jaapschellekens/aurea5-chofu-ctrl/docs/t0vTNs8miWJAVHOMbJF7yNvL.png

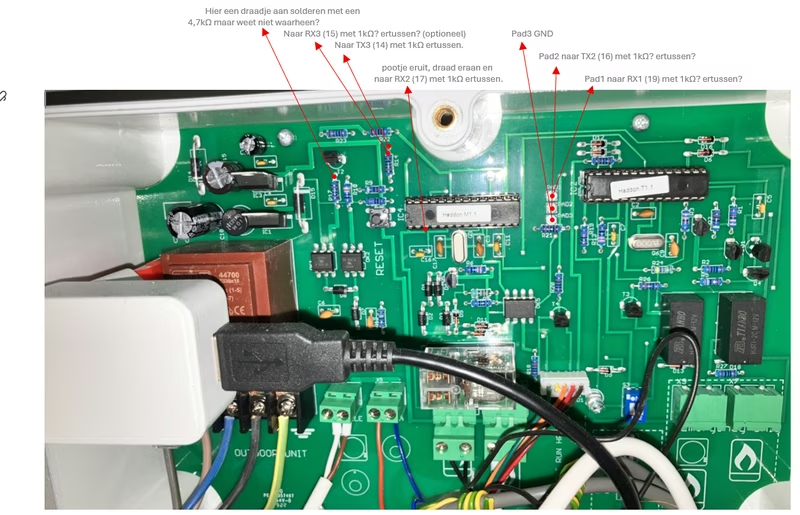
docs/t0vTNs8miWJAVHOMbJF7yNvL.png
