jaapschellekens/aurea5-chofu-ctrl/docs/pins.png

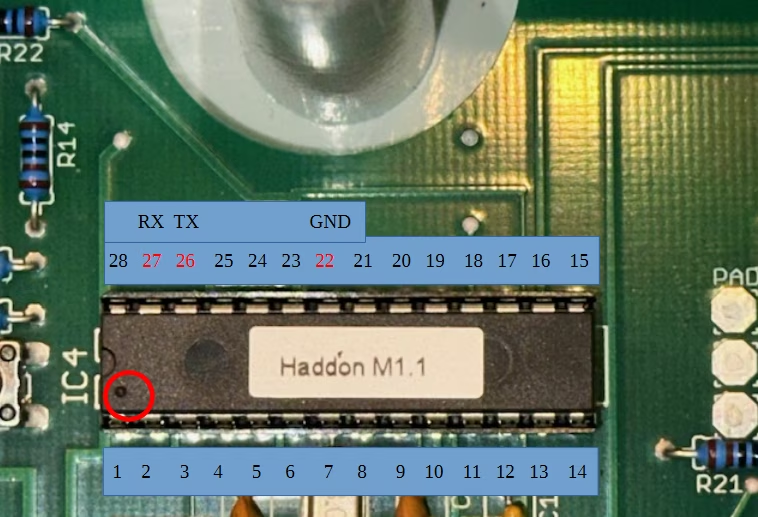
docs/pins.png
