jaapschellekens/aurea5-chofu-ctrl/README.md

# Chofu Warmtepomp Controller

**Arduino UNO R4 WiFi controller voor Chofu (Atlantic aurea 5) hybride warmtepomp met Home Assistant integratie**

> Fork van [kromhoutmaarten-sys/Aurea-5-hybrid_uno4](https://github.com/kromhoutmaarten-sys/Aurea-5-hybrid_uno4)

> Protocol en low level besturing gebaseerd op het werk van WackoH , \_JCG\_ en anderen in tweakers (https://gathering.tweakers.net/forum/list_messages/2220972/0) 





---

## Over Dit Project

Dit is een versie gebaseerd op de geforkte code, aaangevuld met een andere versie van het protocol dat door WackoH en \_JCG\_ is gepubliceerd op de genoemde tweakers thread.

Hoewel ik uiteindelijk veel handmatig heb gedaan is dit voor een groot deel met behulp van claude code en copilot gemaakt. 

De controller spreekt het Chofu 0x19/0x91 serieel protocol op **666 baud** (JGC multi-frame formaat, CRC-CCITT — zie [Protocol](#protocol)), regelt het compressorvermogen in standen 0–8 (handmatig tot 10), en integreert volledig met Home Assistant via MQTT auto-discovery.

- Dit is geen simpele oplossing, het is beperkt getest en kan de boel kapot maken
- Door de chip eruit te halen gaan de controlbox in storing (rode licht op de knop brand). Het gevolg is dat als je anna warmtevraag geeft de controlbox de gasketel aanzet. Mijn oplossing is de ketel in te stellen op tapwater alleen. Je kan de ketel ook op een aparte thermosthaat aansluiten
- De aansturing gaat via MQTT, het makkelijkste is om dat via Home assistant te doen

---

## Features

- **Vijf regelingsmodi** — Auto PID, Auto FF (feedforward), Water PID, Water FF, Handmatig
- **Feedforward controller** — model-gebaseerde stooklijn met online leren van UA_house en UA_emitter
- **Anna/Adam thermostaat support** — leest setpoint en kamertemperatuur via MQTT
- **Plugwise Adam API** (optioneel) — watersetpoint, koelvraag en zonetemperaturen rechtstreeks van de Adam, incl. multi-zone vraagsturing
- **Stooklijn compensatie** — aanvoertemperatuur omhoog bij vorst
- **Vorstbeveiliging** — automatisch bij instelbare grens
- **Koelmodus** — telegram 19-2 byte 3 = 0x02, regelaar draait automatisch om
- **MQTT Auto-Discovery** — entities verschijnen automatisch in Home Assistant
- **LCD display** — 16x2 I2C statusscherm (optioneel)
- **EEPROM opslag** — instellingen blijven na herstart

---

## Regelingsmodi

### Auto modus — PID

PID regelt de aanvoertemperatuur op basis van de kamertemperatuurafwijking (Anna setpoint). De stooklijn berekent het doel-setpoint; de PID past het compressorvermogen (stand) aan.

```
Kamer gewenst: 20.5°C (Anna setpoint)

20.7°C ════ UIT trigger (hysteresis boven)
20.5°C ──── Doel 
20.4°C ════ AAN trigger (hysteresis onder)
```

Geoptimaliseerde PID parameters (KGE-gecalibreerd op historische data):
```
Kp = 19.9   Ki = 0.084   Kd = 0.036
```

---

### Auto modus — FF (Feedforward)

Model-gebaseerde controller die de benodigde aanvoertemperatuur berekent uit de warmtebalans van het huis:

```
T_supply = T_kamer_gewenst + (UA_house / UA_emitter_eff) × (T_kamer_gewenst − T_buiten)
```

De UA_house waarde wordt online bijgeleerd via een integraalterm op de kamerfout. Dit maakt de FF controller robuust voor veranderingen in isolatiewaarden en zonnewinst.

Geoptimaliseerde FF parameters (gecalibreerd op een goed geisoleerd vrijstaand houten huis):
```
ff_UA_house   = 272.5 W/K  (startwaarde, wordt online bijgesteld)
ff_UA_emitter = 267.5 W/K  (UA_eff afgifte-circuit)
FF_KI_AUTO    = 0.026       (integraalversterking kamertemperatuur)
FF_COAST_AUTO = 0.54°C      (anticipatiezone — stand omhoog als fout > 0.54°C)
```

Selecteer modus via MQTT: `chofu/cmd/modus = "ff_auto"`

---

### Water modus — PID

Regelt op een vast aanvoertemperatuur setpoint, ongeacht de kamertemperatuur. Nuttig als sturing op basis van OpenTherm of extern signaal gewenst is. In mijn geval  om de Adam zoneregeling te kunnen gebruiken

```
Setpoint + 1°C ══ UIT trigger
Setpoint        ── Doel 
Setpoint - 1°C ══ AAN trigger
```

Vermogensafbouw is geleidelijk (1 stand per 5 minuten) voor compressorbescherming.

Selecteer: `chofu/cmd/modus = "water"`

---

### Water modus — FF (Feedforward)

Model-gebaseerde variant die de benodigde compressorstand berekent vanuit de gewenste aanvoertemperatuur en de geleerde UA_emitter. De UA_emitter waarde wordt online bijgeleerd via een integraalterm op de aanvoerfout. Rustiger gedrag dan de PID-variant (minder stand-wisselingen).

Geoptimaliseerde FF parameters (KGE-gecalibreerd):
```
ff_UA_emitter  = 267.5 W/K  (startwaarde, wordt online bijgesteld)
FF_KI_WATER    = 0.017       (integraalversterking aanvoertemperatuur)
FF_COAST_WATER = 4.76°C      (anticipatiezone — stand omhoog als fout > 4.76°C)
```

Selecteer: `chofu/cmd/modus = "ff_water"`

---

### Handmatige modus

Vaste compressorstand 0–10 via MQTT. PID/FF niet actief.
(Fabrieksbereik — de originele Atlantic-firmware moduleert t/m stand 10, zie chip-dump `data/atlantic`; de vroegere standen 11/12 waren extrapolaties en zijn geschrapt.)

```
Stand 0  =    0 W  (uit)
Stand 1  =  240 W
Stand 2  =  420 W
Stand 3  =  640 W
Stand 4  =  850 W
Stand 5  = 1050 W
Stand 6  = 1250 W
Stand 7  = 1450 W
Stand 8  = 1550 W  ← maximum in auto/water modus
─────────────────── alleen handmatig ───────────
Stand 9  = 1650 W
Stand 10 = 1700 W
```

---

### Koelmodus

Activeer via `chofu/cmd/koeling = "1"`. Koeling is **alleen beschikbaar** in `ff_auto`, `ff_water` en `handmatig` — niet in `auto` of `water`.

**FF_AUTO koeling** — feedforward op basis van warmte-inval van buiten:
```
P_nodig = UA_house × (t_outside − t_kamer_gewenst)
```
Regelt de compressorstand zodat de kamer op setpoint blijft.

**FF_WATER koeling** — feedforward op basis van kamer→water warmtestroom:
```
P_nodig = UA_emitter × (t_kamer − t_water_gewenst)
```
Regelt de aanvoertemperatuur op `t_water_gewenst` (bijv. 18°C).
Bij elke start vanuit stand 0 draait de pomp eerst 5 minuten op stand 1 voordat
hij naar een hogere berekende stand mag gaan. Dit voorkomt een te harde start
bij koelen.

**HANDMATIG** — vaste stand zoals bij verwarming.

**Condensatiebescherming:** aanvoer daalt nooit onder `SUPPLY_MIN` (default 17°C).  
**Afschakeldrempel:** koeling schakelt terug als kamer/aanvoer meer dan `KOELING_AFSCHAKEL` (0.5°C) onder setpoint zakt.  
**Seizoensbeveiliging:** koeling geblokkeerd als buiten < `KOELING_MIN_BUITEN` (default 18°C).

---

## Protocol

De firmware praat rechtstreeks met de warmtepomp via `Serial1` (D0/D1) op **666 baud, 8N1**. De Arduino vervangt de uitgelezen chip in de Aurea controlbox en is **master**: hij stuurt 4 roterende 0x19-polltelegrammen; de pomp antwoordt per poll met een 0x91-frame.

```
TX (Arduino → pomp):  [0x19][ID 0-3][lenbyte][data...][CRC hi][CRC lo]
RX (pomp → Arduino):  [0x91][ID 0-3][lenbyte][data...][CRC hi][CRC lo]
                      framelengte = lenbyte bytes, GEEN terminator
                      CRC-CCITT (init 0xFFFF, poly 0x1021), residu 0 over heel frame
```

Belangrijke bevindingen (juni 2026, zie [docs/ervaringen.md](docs/ervaringen.md)):

- De lijn is **half-duplex met echo**: eigen TX-bytes komen terug op RX.
- De "eindnul" uit de oorspronkelijke JGC-code is een **AVR-artefact** (break → 0x00); de Renesas-UART van de UNO R4 filtert die weg. Frames zijn exact `lenbyte` bytes.
- ID=2 bevat de temperaturen (aanvoer/retour/buiten, little-endian ×0,1 °C) en op pagina 0 (byte 9 = 0) ook persgas, verdamper, zuiggas en d4; ID=3 byte 3 = compressorfrequentie (×2/3 Hz), byte 9 = stroom (d3 = /5), byte 10 = compressorvermogen/25,6, byte 13 = circulatiepomp; ID=1 byte 4 = defrost, byte 9 = compressor-vrijgave, bytes 5–8 = vermoedelijk alarmvelden (bij wijziging → `chofu/alert`).
- Volledige byte-tabel met betrouwbaarheid per veld: [docs/extra-comm-info.txt](docs/extra-comm-info.txt).
- De JGC-parser (CRC-CCITT) is de enige ondersteunde parser; de pomp antwoordt niet op het oudere 25-byte formaat.

Voor busdiagnose zonder WiFi/MQTT: flash `sniffer/sniffer.ino` (pollt zelf en dumpt alle bytes als hex op USB-serial). Met `chofu/cmd/proto_log = 1` publiceert de firmware hex-frames op `chofu/proto/rx|tx` en elke 30 s een foutensamenvatting (`JGC (30s): CRC +x abort +y ok +z`).

---

## Hardware

### Vereist
- **Arduino UNO R4 WiFi** — hoofdcontroller (of ESP32 als alternatief)
- **LCD 16×2 I2C Display** (optioneel) — statusscherm

### Benodigde Arduino bibliotheken
- `ArduinoMqttClient`
- `LiquidCrystal_I2C` (optioneel, alleen als LCD aangesloten)
- `Arduino_LED_Matrix` (alleen UNO R4 WiFi)
- WiFi is ingebouwd: `WiFiS3` op UNO R4 WiFi, `WiFi` op ESP32

---

## Bedrading

### Warmtepomp seriële verbinding

```
Arduino D0 (RX1) ←── pad "RX" op IC-voetje (pomp → Arduino)
Arduino D1 (TX1) ──→ pad "TX" op IC-voetje (Arduino → pomp, via 1kΩ!)
Arduino GND      ───  GND controlbox
```

> **Let op:** de RX/TX-labels op het IC-voetje zijn vanuit de *verwijderde chip* gezien — de Arduino vervangt die chip en stuurt dus pad "TX" met zijn eigen TX aan. Verkeerd om aangesloten = polls gaan uit maar de pomp antwoordt nooit. Zie [docs/WIRING.md](docs/WIRING.md).

### OpenTherm-link (optioneel, experimenteel)
```
IC-voetje pin 2 ──[10kΩ]──→ D8   (alleen luisteren, fase 1)
```
Zie [docs/WIRING.md](docs/WIRING.md) en [docs/OPENTHERM_LINK_PLAN.md](docs/OPENTHERM_LINK_PLAN.md) — let op de waarschuwingen (T1.1 is onvervangbaar).

### LCD Display (optioneel)
```
VCC → 5V
GND → GND
SDA → A4
SCL → A5
```

---

## Installatie

### 1. Bibliotheken installeren
Arduino IDE → Sketch → Bibliotheek beheren:
- `ArduinoMqttClient` 
- `LiquidCrystal_I2C` 

### 2. Configuratie aanmaken
Kopieer het voorbeeldbestand en vul je eigen gegevens in:
```bash
cp chofu_wp_ff/config.h.example chofu_wp_ff/config.h
```
Bewerk `chofu_wp_ff/config.h`:
```cpp
const char* SSID        = "jouw-netwerk";
const char* PASS        = "jouw-wachtwoord";
const char* MQTT_BROKER = "192.168.1.x";
const int   MQTT_PORT   = 1883;
const char* MQTT_USER   = "";   // leeg als geen auth
const char* MQTT_PASS   = "";
```
`config.h` staat in `.gitignore` en wordt nooit gecommit.

### 3. Firmware uploaden
Open `chofu_wp_ff/chofu_wp_ff.ino` en upload naar Arduino UNO R4 WiFi.

> **⏱ Koude-start vertraging:** Na elke upload of stroomonderbreking blijft de WP **5 minuten** op stand 0 voordat de regelaar ingrijpt. Na 5 minuten verschijnt `"Koude-start vertraging afgelopen"` op `chofu/log/INFO`.

### 3. Home Assistant
Entities verschijnen automatisch via MQTT discovery zodra de Arduino verbonden is. Geen YAML configuratie nodig.

Zie [docs/INSTALLATION.md](docs/INSTALLATION.md) voor uitgebreide stap-voor-stap instructies.

---

## MQTT Topics

### State (Arduino → HA)

| Topic | Omschrijving | Eenheid |
|---|---|---|
| `chofu/supply` | Aanvoertemperatuur | °C |
| `chofu/return` | Retourtemperatuur | °C |
| `chofu/outside` | Buitentemperatuur | °C |
| `chofu/kamer` | Kamertemperatuur (Anna) | °C |
| `chofu/kamer_gewenst` | Gewenste kamertemperatuur | °C |
| `chofu/stand` | Compressorstand (0–10) | — |
| `chofu/vermogen` | Gemeten compressorvermogen | W |
| `chofu/stroom` | Stroom (display d3) | — |
| `chofu/comp_hz` | Compressorfrequentie | Hz |
| `chofu/t_persgas` | Persgastemperatuur | °C |
| `chofu/comp_vrijgave` | Compressor vrijgegeven door pomp | 0/1 |
| `chofu/circ_pomp` | Circulatiepomp draait | 0/1 |
| `chofu/diag` | Diagnose-JSON (verdamper, zuiggas, ventilator, EEV, statusbytes) | JSON |
| `chofu/delta_t` | Aanvoer − retour | °C |
| `chofu/modus` | Huidige modus | auto/ff_auto/water/ff_water/handmatig |
| `chofu/stooklijn_basis` | Actief aanvoer setpoint | °C |
| `chofu/doel_setpoint` | Actief regelsetpoint (stooklijn bij verwarming, kamer/water bij koeling) | °C |
| `chofu/water_setpoint` | Water modus setpoint | °C |
| `chofu/pid` | PID uitvoer | % |
| `chofu/ff_ua_house` | Geleerde UA_house (FF) | W/K |
| `chofu/ff_ua_emitter` | Geleerde UA_emitter (FF) | W/K |
| `chofu/koeling` | Koelmodus actief | 0/1 |
| `chofu/supply_min` | Condensatiegrens koeling | °C |
| `chofu/koeling_afschakel` | Afschakeldrempel koeling | °C |
| `chofu/defrost` | Ontdooien actief | 0/1 |
| `chofu/aan` | WP actief | 0/1 |
| `chofu/t_vorst` | Vorstbeveiligingsgrens | °C |
| `chofu/status` | Verbindingsstatus | online/offline |

### Commands (HA → Arduino)

| Topic | Omschrijving | Waarden |
|---|---|---|
| `chofu/cmd/modus` | Selecteer modus | `auto` / `ff_auto` / `water` / `ff_water` / `handmatig` |
| `chofu/cmd/stand` | Vaste stand (→ handmatig) | 0–10 |
| `chofu/cmd/water_setpoint` | Aanvoer setpoint water modus (koeling: ~16–20) | 16–55°C |
| `chofu/cmd/stooklijn_basis` | Aanvoer setpoint auto stooklijn | 20–45°C |
| `chofu/cmd/koeling` | Koelmodus aan/uit | 0/1 |
| `chofu/cmd/koeling_min_buiten` | Min. buitentemp voor koeling (EEPROM) | 0–30°C |
| `chofu/cmd/supply_min` | Condensatiebescherming koeling (EEPROM) | 10–25°C |
| `chofu/cmd/koeling_afschakel` | Afschakeldrempel koeling | 0.1–5.0°C |
| `chofu/cmd/adam_bron` | Plugwise Adam bron (EEPROM) | `uit`/`water`/`water+kamer`/`multi` |
| `chofu/cmd/adam_koel_sp` | Watersetpoint bij Adam-koelvraag (EEPROM) | 16–25°C |
| `chofu/cmd/proto_log` | Protocol hex-logging aan/uit | 0/1 |
| `chofu/cmd/power` | WP aan/uit | 0/1 |
| `chofu/cmd/t_vorst` | Vorstgrens | −10 tot 10°C |
| `chofu/cmd/kp` / `ki` / `kd` | PID parameters | getal |
| `chofu/cmd/ff_ua_house` | FF UA_house overschrijven | W/K |
| `chofu/cmd/ff_ua_emitter` | FF UA_emitter overschrijven | W/K |
| `chofu/cmd/ff_save` | FF leerwaarden opslaan in EEPROM | 1 |
| `chofu/cmd/stooklijn_grens` | Buitentemp grens stooklijn | °C |
| `chofu/cmd/stooklijn_factor` | Stooklijn steilheid | 0.1–5.0 |
| `chofu/cmd/supply_max` | Max aanvoertemperatuur | °C |
| `chofu/cmd/force_start` | Hysteresis overbruggen | 1 |
| `chofu/cmd/hyst_slow` / `fast` / `down` | Hysteresistijden | ms |

### Subscriptions (Arduino leest)

| Topic | Omschrijving |
|---|---|
| `chofu/cmd/kamer_setpoint` | Anna thermostaat setpoint |
| `chofu/cmd/kamer` | Anna kamertemperatuur |

### Log

| Topic | Omschrijving |
|---|---|
| `chofu/log/INFO` | Normale events |
| `chofu/log/WARNING` | Waarschuwingen |
| `chofu/alert` | Persistente waarschuwing (retained) |

---

## Plugwise Adam integratie (ingebouwd)

De firmware kan optioneel rechtstreeks de lokale REST API van de Plugwise Adam pollen (`adam.h`/`adam.cpp`, niet-blokkerend, elke 30 s). Volledig ontwerp: [docs/ADAM_INTEGRATIE_PLAN.md](docs/ADAM_INTEGRATIE_PLAN.md).

**Activeren:** zet in `config.h`:
```cpp
#define ADAM_IP   "192.168.1.x"
#define ADAM_PASS "abcd1234"     // Smile-ID van sticker
#define ADAM_ZONE "Woonkamer"    // zonenaam voor bron water+kamer
```
en kies een bron via `chofu/cmd/adam_bron` (EEPROM):

| Bron | Gedrag |
|---|---|
| `uit` | Adam wordt niet gebruikt (default); MQTT-bronnen zoals voorheen |
| `water` | `intended_boiler_temperature` → `t_water_gewenst` (water/ff_water) |
| `water+kamer` | Als `water`, plus temperatuur van `ADAM_ZONE` → `t_kamer` |
| `multi` | Als `water`, plus regelen op de zone met de **grootste vraag** (setpoint − temp, 0,3 °C wissel-hysterese); het zonesetpoint vervangt het Anna-setpoint |

**Watersetpoint-interpretatie** (Anna via Adam): `0` = geen vraag → WP uit; `10` = **koelvraag** → koeling aan op `chofu/cmd/adam_koel_sp` (default 18 °C, alleen ff_water); `≥ 16` = verwarmen op dat setpoint.

**Terugval:** is de API > 90 s onbereikbaar, dan gelden weer de laatste MQTT-waarden + alert. Alle beveiligingen (SUPPLY_MIN, KOELING_MIN_BUITEN, vorst) blijven leidend.

**State topics:** `chofu/adam/bron`, `chofu/adam/sp`, `chofu/adam/status`, `chofu/adam/koel_sp`, `chofu/adam/zone/<naam>` (+ `_sp`), `chofu/adam/actieve_zone` (multi).

De map `adam_api_test/` bevat de oorspronkelijke proof-of-concept plus `adam_discover.py` (Python) om zonenamen en beschikbare data te verkennen.

---

## Python simulatietools

De map `python/` bevat tools voor het optimaliseren en valideren van regelparameters op historische Home Assistant data.

| Script | Functie |
|---|---|
| `replay_simulation.py` | Simuleer controller op historische CSV data |
| `optimize_all.py` | Optimaliseer PID en FF parameters (KGE objectief) |
| `calibrate_housemodel.py` | Kalibreer UA_house, C_th, UA_emitter op historische kamertemperatuur |

**Data-indeling:** exporteer via Home Assistant → Geschiedenis → CSV. Ondersteunt zowel het oude (entity/state) als het nieuwere formaat met `climate`-entiteiten en OpenTherm-sensoren.

---

## Troubleshooting

### Entities verschijnen niet in Home Assistant
- Wacht 2–3 minuten na opstarten
- Check of MQTT integratie geïnstalleerd is
- Controleer `chofu/status` topic in MQTT Explorer — moet "online" tonen
- Herstart Home Assistant als entities na integratie-reload verdwijnen

### WP gaat niet aan
- Hysteresis actief? (standaard 10 min)
- Override via: `chofu/cmd/force_start = 1`
- Check of modus correct is: `chofu/modus`

### Arduino bevriest na enige tijd
- Gebruik uitsluitend de hardware UART (Serial1, pins D0/D1) voor de WP-communicatie. SoftwareSerial conflicteert met de WiFi co-processor van de UNO R4 WiFi.

### Geen of corrupte protocol-communicatie
- Zet `chofu/cmd/proto_log = 1` en kijk naar de 30s-samenvatting: `JGC (30s): CRC +x abort +y ok +z`. Gezond is `ok` in de tientallen en CRC/abort ~0.
- `JGC timeout: geen frame >2s` + geen antwoord → D0/D1 waarschijnlijk verwisseld (labels op IC-voetje zijn vanuit de verwijderde chip!)
- Voor diagnose op byte-niveau: flash `sniffer/sniffer.ino` (geen WiFi, hex-dump op USB-serial)

---

## Documentatie

- [docs/INSTALLATION.md](docs/INSTALLATION.md) — Installatie handleiding
- [docs/WIRING.md](docs/WIRING.md) — Bekabelingsschema's
- [docs/MQTT_REFERENCE.md](docs/MQTT_REFERENCE.md) — Volledige MQTT referentie
- [docs/TUNING.md](docs/TUNING.md) — PID en feedforward parameter tuning gids
- [docs/STOOKLIJN.md](docs/STOOKLIJN.md) — Stooklijn werking en instelling
- [docs/LCD.md](docs/LCD.md) — LCD scherm-indeling per modus
- [docs/ervaringen.md](docs/ervaringen.md) — Valkuilen en bevindingen uit de ontwikkeling
- [docs/ESPHOME_AVR_BRUG_PLAN.md](docs/ESPHOME_AVR_BRUG_PLAN.md) — Plan: ATmega328P-brug in IC2 en eventuele overstap naar ESPHome

---

## Credits

Protocol reverse engineering: WackoH (Tweakers.net) — [Tweakers topic](https://gathering.tweakers.net/forum/list_messages/2220972/0)
Fork van [kromhoutmaarten-sys/Aurea-5-hybrid_uno4](https://github.com/kromhoutmaarten-sys/Aurea-5-hybrid_uno4)

**Bibliotheken:**
- ArduinoMqttClient (Arduino)
- LiquidCrystal_I2C (Frank de Brabander)

---

## Licentie

MIT License — zie [LICENSE](LICENSE) voor details.
