jaapschellekens/aurea5-chofu-ctrl/docs/MQTT_REFERENCE.md

# MQTT Referentie - ChofuCtrl

Complete overzicht van alle MQTT topics, commando's en HA discovery entiteiten.

MQTT Broker: `<YOUR_MQTT_BROKER_IP>:1883`  
Alle topics gebruiken het prefix `chofu/` (instelbaar — zie hieronder).

---

## MQTT-prefix / HA-device (testbord naast productie)

De topic-prefix en de Home Assistant device-identiteit zijn **compile-time**
instelbaar via drie macro's in `chofu_wp_ff/types.h`:

| Macro | Default (productie) | Bepaalt |
|---|---|---|
| `MQTT_PREFIX` | `chofu` | Prefix van álle topics (`<prefix>/...`) |
| `HA_NODE` | `chofu_hp` | HA device-id, alle `unique_id`'s, discovery-node, **én de MQTT client-ID** |
| `HA_DEV_NAME` | `Chofu WP` | Weergavenaam van het HA-device |

In deze referentie staat overal `chofu/...`; lees dat als `<MQTT_PREFIX>/...`.

**Tweede (test)bord naast het draaiende systeem:** zet op het testbord bv.
`MQTT_PREFIX "chofu_test"`, `HA_NODE "chofu_test_hp"`, `HA_DEV_NAME "Chofu WP TEST"`.
Omdat `HA_NODE` ook de `unique_id`'s, het device-id én de MQTT client-ID verandert,
ziet HA een **apart apparaat** en botsen de broker-verbindingen niet (geen
reconnect-storm). De productietopics/-entiteiten blijven onaangeroerd.

> Niet in `config.h` zetten: dat bestand wordt niet door alle `.cpp`-bestanden
> gezien → zou inconsistente topics geven. Kan ook globaal via build-flag,
> bv. `-DMQTT_PREFIX="\"chofu_test\""`.

De simulator `python/wp_simulator.py` heeft een bijpassende `--prefix`-optie
(default `chofu`); zet die gelijk aan `MQTT_PREFIX`, bv. `--prefix chofu_test`.

---

## State Topics (Arduino → Home Assistant)

Alle state topics worden elke **10 seconden** gepubliceerd. HA discovery zorgt automatisch voor de entiteiten.

### Temperaturen

| Topic | Type | Unit | Beschrijving |
|---|---|---|---|
| `chofu/supply` | float | °C | Aanvoer temperatuur |
| `chofu/return` | float | °C | Retour temperatuur |
| `chofu/outside` | float | °C | Buiten temperatuur |
| `chofu/delta_t` | float | °C | Delta T (aanvoer − retour) |
| `chofu/kamer` | float | °C | Kamer temperatuur (van Anna) |
| `chofu/kamer_gewenst` | float | °C | Gewenste kamer temperatuur (van Anna) |
| `chofu/kamer_geldig` | string | 0/1 | Kamertemperatuur ooit ontvangen (0 = nog nooit via cmd/kamer) |
| `chofu/kamer_in_water` | string | 0/1 | Kamertemp actief in ff_water/water-modi |
| `chofu/stooklijn_basis` | float | °C | Aanvoer setpoint (auto modus stooklijn) |
| `chofu/water_setpoint` | float | °C | Gewenste aanvoertemperatuur (water modus); 0 = geen warmtevraag |
| `chofu/water_sp_min` | float | °C | Minimaal geldig water setpoint (exclusief 0) |
| `chofu/t_vorst` | float | °C | Actieve vorstgrens |

### Status

| Topic | Type | Values | Beschrijving |
|---|---|---|---|
| `chofu/stand` | int | 0–10 | Huidige compressor stand |
| `chofu/vermogen` | int | W | Compressorvermogen (gemeten: frame 91-3 byte 10 × 25.6; terugval: standtabel) |
| `chofu/aan` | string | 0/1 | Warmtepomp aan/uit |
| `chofu/modus` | string | auto/ff_auto/water/ff_water/handmatig | Regelingsmodus |
| `chofu/doel_setpoint` | float | °C | Actief doel-setpoint (stooklijn) |
| `chofu/koeling` | string | 0/1 | Koelstand actief |
| `chofu/pid` | float | % | PID/FF output |
| `chofu/ff_ua_house` | float | W/K | Geleerde UA huis (FF auto) |
| `chofu/ff_ua_emitter` | float | W/K | Geleerde UA emitter (FF water) |
| `chofu/defrost` | string | 0/1 | Defrost actief |
| `chofu/stroom` | float | — | Stroom zoals display d3 (frame 91-3 byte 9 / 5; eenheid niet bewezen). Vervangt het oude `chofu/stand_echo`, dat een verkeerde interpretatie was |
| `chofu/comp_hz` | int | Hz | Compressorfrequentie (91-3 byte 3 × 2/3, display d1) |
| `chofu/t_persgas` | int | °C | Persgastemperatuur (91-2 byte 13, display d2) |
| `chofu/comp_vrijgave` | string | 0/1 | Pomp geeft compressor vrij (91-1 byte 9 ≠ 0); 0 tijdens de ~3 min herstartblokkade en vlak vóór defrost |
| `chofu/circ_pomp` | string | 0/1 | Circulatiepomp draait (91-3 byte 13: 24 = uit, ~152 = aan); loopt ~1¾ min vóór de compressor aan en draait na |
| `chofu/diag` | JSON | — | Diagnose: `t_verdamper`, `t_zuiggas`, `t_d4` (°C, raw/2 − 41), `ventilator_rpm`, `ventilator_doel_rpm`, `eev` (pulsen), statusbytes (hex) en onbekende bytes |
| `chofu/lcd` | string | 0/1 | LCD backlight status |
| `chofu/sim_actief` | string | 0/1 | Simulatiemodus actief |
| `chofu/proto_log` | string | 0/1 | Protocol logging actief |

### Safeguard Grenzen (instelbaar)

| Topic | Type | Unit | Default | Beschrijving |
|---|---|---|---|---|
| `chofu/supply_max` | float | °C | 60.0 | Noodstop aanvoer temperatuur |
| `chofu/koeling_min_buiten` | float | °C | 18.0 | Minimale buitentemp voor koeling |
| `chofu/supply_min` | float | °C | 17.0 | Condensatiebescherming koeling |
| `chofu/koeling_afschakel` | float | °C | 0.5 | Afschakeldrempel koeling (niet EEPROM) |
| `chofu/stooklijn_uit` | float | °C | 18.0 | Boven deze buitentemp: verwarming uit (auto) |
| `chofu/stooklijn_aan` | float | °C | 16.0 | Onder deze buitentemp: verwarming hervat (hysteresis) |

### Systeem

| Topic | Type | Retained | Beschrijving |
|---|---|---|---|
| `chofu/status` | string | ✅ | `online` / `offline` (LWT) |
| `chofu/alert` | string | ✅ | Laatste waarschuwing of foutmelding |
| `chofu/log/INFO` | string | ❌ | Normale events |
| `chofu/log/WARNING` | string | ❌ | Waarschuwingen (ook via alert) |
| `chofu/log/ERROR` | string | ❌ | Fouten |

> `chofu/alert` is retained: HA toont altijd het laatste bericht, ook na herstart.

---

## Command Topics (Home Assistant → Arduino)

### Modus

```
Topic:   chofu/cmd/modus
Payload: "auto"      → PID regeling op kamertemperatuur (Anna)
         "ff_auto"   → Feedforward op kamertemperatuur (leert UA_house)
         "water"     → PID regeling op aanvoertemperatuur
         "ff_water"  → Feedforward op aanvoertemperatuur (leert UA_emitter)
                       Werkt ook zonder kamertemperatuur — zie kamer_in_water.
         "handmatig" → Vaste stand via chofu/cmd/stand
```

### Power

```
Topic:   chofu/cmd/power
Payload: "1" → AAN (schakelt naar handmatig stand 1)
         "0" → UIT (handmatig stand 0)
```

### Handmatige Stand

```
Topic:   chofu/cmd/stand
Payload: "0" – "10"  (integer)

Schakelt automatisch naar handmatige modus.
Stands 9–10 zijn alleen beschikbaar in handmatige modus.
(Fabrieksbereik t/m 10 — bevestigd door de chip-dump; standen 11/12 geschrapt.)

Stand mapping:
  0  = UIT           (   0 W)
  1  = Minimum       ( 240 W)
  2  = Laag          ( 420 W)
  3  = Medium-       ( 640 W)
  4  = Medium        ( 850 W)
  5  = Medium+       (1050 W)
  6  = Hoog          (1250 W)
  7  = Hoog+         (1450 W)
  8  = Max auto      (1550 W)  ← max in auto/water modus
  9  = Uitgebreid-   (1650 W)  ← alleen handmatig
 10  = Maximum       (1700 W)  ← alleen handmatig
```

### Water Modus

```
Topic:   chofu/cmd/water_setpoint
Payload: "0"              → geen warmtevraag: WP uit (vorstbeveiliging blijft actief)
         "<WATER_SP_MIN>"–"55.0" → gewenste aanvoertemperatuur verwarming (float, °C)
         "<SUPPLY_MIN>"–"55.0"   → gewenste aanvoertemperatuur koeling (float, °C)

Stel gewenste aanvoertemperatuur in (WATER / FF_WATER modus).
Waarde 0 wordt gebruikt door externe regelaars (bijv. Plugwise Adam) om aan te geven
dat er geen warmtevraag is — de WP wordt dan uitgeschakeld.

Koeling aan/uit zet je via chofu/cmd/koeling (niet automatisch via het setpoint).

Clamp-logica (geen silent negeren):
  Waarden onder SUPPLY_MIN (exclusief 0) → geclampt op SUPPLY_MIN
    en alert gepubliceerd op chofu/alert.
  Waarden tussen SUPPLY_MIN en WATER_SP_MIN in verwarmingsmodus → genegeerd
    (onzinnige verwarmingsvraag).
  Waarden boven WATER_SP_MIN → altijd geaccepteerd.

Tolerantie ±1°C:
  setpoint + 1°C → UIT
  setpoint − 1°C → AAN

Niet opgeslagen in EEPROM (reset naar standaardwaarde na herstart).
```

```
Topic:   chofu/cmd/water_sp_min
Payload: "10.0"–"30.0"  (float, °C)
State:   chofu/water_sp_min

Minimale geldige waarde voor chofu/cmd/water_setpoint (exclusief 0).
Waarden tussen 1 en water_sp_min worden genegeerd — handig om per ongeluk
te lage setpoints van een externe regelaar te blokkeren.
Opgeslagen in EEPROM. Default: 16°C.
```

**Regelgedrag water modus (voorbeeld setpoint 40°C):**
```
41.0°C ════ UIT trigger ✋
40.0°C ──── DOEL ✅
39.0°C ════ AAN trigger 🔥

Hysteresis bij standwijziging:
  Omlaag:        1 min  (HYST_DOWN_MS — water/ff_water)
                 5 min  (AUTO_HYST_DOWN_MS — auto/ff_auto)
  Omhoog groot:  2 min  (HYST_FAST_MS, fout > 5°C)
  Omhoog normaal:10 min (HYST_SLOW_MS)
```

### Koeling

```
Topic:   chofu/cmd/koeling
Payload: "1" → Koelen
         "0" → Verwarmen (default)

Koeling is alleen beschikbaar in ff_auto, ff_water en handmatig.
In auto of water wordt het commando genegeerd met een alert.

FF_AUTO:  P_nodig = UA_house × (t_outside − t_kamer_gewenst)
FF_WATER: P_nodig = UA_emitter × (t_kamer − t_water_gewenst)   [met kamer]
          P_nodig = UA_emitter × (t_outside − t_water_gewenst)  [zonder kamer]
          Bij start vanuit stand 0: eerst 5 min stand 1, daarna pas hoger.
HANDMATIG: vaste stand, ongewijzigd.

Zet protocol byte 19-2,3 op 2 (koeling) i.p.v. 1 (verwarming).
Wordt automatisch uitgeschakeld als buiten < KOELING_MIN_BUITEN.
Niet opgeslagen in EEPROM.

Typisch gebruik FF_AUTO:
  chofu/cmd/modus          = "ff_auto"
  chofu/cmd/koeling        = "1"

Typisch gebruik FF_WATER:
  chofu/cmd/modus          = "ff_water"
  chofu/cmd/water_setpoint = "18.0"
  chofu/cmd/koeling        = "1"
```

**Condensatiebescherming (SUPPLY_MIN):**
```
Topic:   chofu/cmd/supply_min
Payload: "10.0" – "25.0"  (float, °C)
Aanvoer daalt nooit onder deze grens (voorkomt condensatie op vloer/plafond).
Opgeslagen in EEPROM. Default: 17.0°C
```

**Afschakeldrempel (KOELING_AFSCHAKEL):**
```
Topic:   chofu/cmd/koeling_afschakel
Payload: "0.1" – "5.0"  (float, °C)
Koeling schakelt terug als kamer/aanvoer meer dan deze waarde onder setpoint daalt.
Niet opgeslagen in EEPROM. Default: 0.5°C
```

### Stooklijn Parameters

```
Topic:   chofu/cmd/stooklijn_basis
Payload: "20.0" – "45.0"  (float, °C)
Opgeslagen in EEPROM. Default: 28.0°C

Topic:   chofu/cmd/t_vorst
Payload: "-10.0" – "10.0"  (float, °C)
Vorstgrens: WP blijft minimaal stand 1 bij buiten < T_VORST.
Opgeslagen in EEPROM. Default: 2.0°C

Topic:   chofu/cmd/stooklijn_grens
Payload: "0.0" – "25.0"  (float, °C)
Onder deze buitentemp wordt het setpoint verhoogd. Default: 15.0°C

Topic:   chofu/cmd/stooklijn_factor
Payload: "0.1" – "5.0"  (float)
°C setpointverhoging per °C onder de grens. Default: 0.68
Voorbeeld: buiten 5°C, grens 15°C, factor 0.68 → +6.8°C setpoint
```

### PID Parameters

```
AUTO modus:
  Topic:   chofu/cmd/kp     Payload: float  Default: 75.0
  Topic:   chofu/cmd/ki     Payload: float  Default: 0.800
  Topic:   chofu/cmd/kd     Payload: float  Default: 0.010

WATER modus (aparte set — hogere Kp voor aanvoer-tracking):
  Topic:   chofu/cmd/kp_water     Payload: float  Default: 50.0
  Topic:   chofu/cmd/ki_water     Payload: float  Default: 0.800
  Topic:   chofu/cmd/kd_water     Payload: float  Default: 0.010

Alle PID parameters opgeslagen in EEPROM.
```

### Feedforward Parameters

```
Topic:   chofu/cmd/ff_ua_house
Payload: "50" – "500"  (float, W/K)
UA_house overschrijven. Wordt ook online bijgeleerd.
Opgeslagen in EEPROM. Default: 272.5 W/K

Topic:   chofu/cmd/ff_ua_emitter
Payload: "50" – "500"  (float, W/K)
UA_emitter overschrijven. Wordt ook online bijgeleerd.
Opgeslagen in EEPROM. Default: 250.0 W/K

Topic:   chofu/cmd/ff_save
Payload: "1"
Sla de huidige geleerde UA-waarden op in EEPROM.
```

### Safeguard Grenzen

```
Topic:   chofu/cmd/supply_max
Payload: "40.0" – "80.0"  (float, °C)
Noodstop: aanvoer boven deze temp → stand 0, ongeacht modus.
Opgeslagen in EEPROM. Default: 60.0°C

Topic:   chofu/cmd/koeling_min_buiten
Payload: "0.0" – "30.0"  (float, °C)
Koeling geblokkeerd als buiten < deze grens.
Opgeslagen in EEPROM. Default: 18.0°C

Topic:   chofu/cmd/stooklijn_uit
Payload: "5.0" – "30.0"  (float, °C)
Auto modus: verwarming stopt als buiten > deze grens.
Opgeslagen in EEPROM. Default: 18.0°C

Topic:   chofu/cmd/stooklijn_aan
Payload: "5.0" – "30.0"  (float, °C)
Auto modus: verwarming hervat als buiten < deze grens (na uitschakelstop).
Hysteresis t.o.v. stooklijn_uit — voorkomt snelle aan/uit-cycli.
Opgeslagen in EEPROM. Default: 16.0°C
```

### Overig

```
Topic:   chofu/cmd/lcd
Payload: "1" → LCD backlight aan
         "0" → LCD backlight uit

Topic:   chofu/cmd/force_start
Payload: "1"
Reset hysteresis timer → warmtepomp start direct.
```

---

## Safeguards

Overzicht van alle ingebouwde beveiligingen:

| Safeguard | Conditie | Actie | Instelbaar |
|---|---|---|---|
| **Noodstop aanvoer** | `t_supply > SUPPLY_MAX` (60°C) | Stand 0, WP uit | `chofu/cmd/supply_max` |
| **Vorstbeveiliging** | `t_outside < T_VORST` (2°C) | Minimaal stand 1 | `chofu/cmd/t_vorst` |
| **Koeling blokkering** | `koeling=1` en `buiten < 18°C` | Koeling automatisch uit | `chofu/cmd/koeling_min_buiten` |
| **Stooklijn uit** | `buiten > 18°C` in auto modus | Stand 0, WP uit | `chofu/cmd/stooklijn_uit` |
| **Stooklijn aan** | `buiten < 16°C` na uitschakelstop | Verwarming hervat | `chofu/cmd/stooklijn_aan` |
| **Spike filter aanvoer/retour** | Sprong > 10°C per cyclus | Waarde verworpen, vorige behouden | — |
| **Spike filter buiten** | Sprong > 5°C of buiten −30..+50°C | Waarde verworpen | — |
| **MQTT watchdog** | Geen MQTT > 120 min | Water/handmatig → auto | — |

Alle safeguard meldingen verschijnen op `chofu/alert` (retained) en `chofu/log/WARNING`.

### Alert Voorbeelden

```
"NOODSTOP aanvoer: 63.2C > max 60.0C"
"Koeling geblokkeerd: buiten 15.3C < min 18.0C"
"Spike aanvoer: 72.1C verworpen (was 42.3C)"
"Spike buiten: 88.5C verworpen"
"Verwarming gestopt: buiten 19.2C > 18.0C"
"MQTT watchdog: geen contact > 120 min, terug naar auto"
"❄️ VORSTBEVEILIGING! Buiten: 1.2°C → Stand 1"
```

---

## Max compressorstand

Begrenst de hoogste compressorstand in **alle modi behalve `handmatig`** (en behalve
tijdens SWW, dat een eigen limiet heeft). Handig om geluid/verbruik te beperken.
Persistent in EEPROM.

| Topic | Richting | Waarde | Beschrijving |
|---|---|---|---|
| `chofu/cmd/max_stand` | HA→Arduino | 1–8 | Max stand (default 8 = geen limiet) |
| `chofu/max_stand` | Arduino→HA | 1–8 | Actuele max stand |

HA-entiteit: **Chofu Max Stand** (number).

## SWW (tapwater / DHW)

Overlay-modus die de actieve regeling **tijdelijk overneemt** om het tapwatervat te
laden. Activeren vanuit HA (bv. via een vat-thermostaat of schema). Bij activeren:
schakelt de driewegklep-relais (`SWW_KLEP_PIN`, instelbaar in `types.h`), zet koeling
uit, en regelt de aanvoer naar `SWW_SETPOINT` begrensd op `SWW_MAX_STAND`. De
`MAX_STAND`-limiet geldt **niet** tijdens SWW. HA bepaalt start/stop (de firmware
kent de vattemperatuur niet). Setpoint en stand zijn persistent; `sww` zelf is
runtime (na reboot uit).

| Topic | Richting | Waarde | Beschrijving |
|---|---|---|---|
| `chofu/cmd/sww` | HA→Arduino | 0/1 | Tapwater laden aan/uit |
| `chofu/cmd/sww_setpoint` | HA→Arduino | 30–60 °C | Laad-aanvoertemperatuur (default 50) |
| `chofu/cmd/sww_max_stand` | HA→Arduino | 1–8 | Max stand tijdens SWW (default 8) |
| `chofu/sww` | Arduino→HA | 0/1 | SWW actief |
| `chofu/sww_klep` | Arduino→HA | 0/1 | **Klepstand** (retained): 1 = open naar tapwatervat. HA kan hierop een eigen relais sturen als de Arduino de klep niet kan schakelen. |
| `chofu/sww_setpoint` | Arduino→HA | °C | Actueel SWW-setpoint |
| `chofu/sww_max_stand` | Arduino→HA | 1–8 | Actuele SWW-max-stand |

HA-entiteiten: **Chofu SWW** (switch), **Chofu SWW Setpoint** (number),
**Chofu SWW Max Stand** (number).

> Bedrading: `SWW_KLEP_PIN` (default ESP32 GPIO25 / UNO R4 D2) stuurt het
> klep-relais. Polariteit via `SWW_KLEP_ACTIEF_HOOG`. Pas beide aan in `types.h`.

---

## Home Assistant Auto-Discovery

De Arduino publiceert alle HA discovery configs automatisch bij opstart (retained). Handmatige YAML configuratie is **niet** nodig.

> **⏱ Koude-start vertraging:** Na elke (her)start blijft `ctrl.stand` geforceerd op 0 gedurende **5 minuten** (`BOOT_DELAY_MS`). De WP communiceert normaal maar draait niet. Na afloop verschijnt `"Koude-start vertraging afgelopen — regelaar actief"` op `chofu/log/INFO`.

**Entiteiten (26 totaal):**

| Entiteit | Type | Topic |
|---|---|---|
| Chofu Aanvoer | sensor (°C) | `chofu/supply` |
| Chofu Retour | sensor (°C) | `chofu/return` |
| Chofu Buiten | sensor (°C) | `chofu/outside` |
| Chofu Delta T | sensor (°C) | `chofu/delta_t` |
| Chofu Kamer | number (°C) | `chofu/cmd/kamer` |
| Chofu Kamer Gewenst | sensor (°C) | `chofu/kamer_gewenst` |
| Chofu Kamertemp in water-modi | switch | `chofu/cmd/kamer_in_water` |
| Chofu Stooklijn Basis | number (°C) | `chofu/cmd/stooklijn_basis` |
| Chofu Doel Setpoint | sensor (°C) | `chofu/doel_setpoint` |
| Chofu Stand | sensor | `chofu/stand` |
| Chofu Vermogen | sensor (W) | `chofu/vermogen` |
| Chofu Modus | sensor | `chofu/modus` |
| Chofu PID | sensor (%) | `chofu/pid` |
| Chofu Pomp | sensor | `chofu/pomp` |
| Chofu Comp Hz | sensor (Hz) | `chofu/comp_hz` |
| Chofu Defrost | binary_sensor | `chofu/defrost` |
| Chofu Simulatie | binary_sensor | `chofu/sim_actief` |
| Chofu Alert | sensor | `chofu/alert` |
| Chofu Power | switch | `chofu/cmd/power` |
| Chofu LCD | switch | `chofu/cmd/lcd` |
| Chofu Koeling | switch | `chofu/cmd/koeling` |
| Chofu Koeling Aanvoer Min | number (°C) | `chofu/cmd/supply_min` |
| Chofu Koeling Afschakeldrempel | number (°C) | `chofu/cmd/koeling_afschakel` |
| Chofu Modus Select | select | `chofu/cmd/modus` |
| Chofu Water SP | number (°C) | `chofu/cmd/water_setpoint` |
| Chofu Water SP Min | number (°C) | `chofu/cmd/water_sp_min` |
| Chofu Vorstgrens | number (°C) | `chofu/cmd/t_vorst` |
| Chofu Stand (handmatig) | number | `chofu/cmd/stand` |
| Chofu Aanvoer Max | number (°C) | `chofu/cmd/supply_max` |
| Chofu Koeling Min Buiten | number (°C) | `chofu/cmd/koeling_min_buiten` |
| Chofu Stooklijn Uit | number (°C) | `chofu/cmd/stooklijn_uit` |

**Availability:** Alle entiteiten zijn gekoppeld aan `chofu/status`. Bij verbindingsverlies (LWT) zet de broker automatisch `offline` en markeert HA alle entiteiten als niet beschikbaar.

---

## Simulatie Topics (Testen Zonder Hardware)

Met deze topics kunnen sensorwaarden worden overschreven voor testen zonder hardware aansluiting. De simulatiewaarden worden elke loop-iteratie toegepast vóór de PID berekening en alle safeguards.

**`chofu/sim_actief`** (state, retained) toont in HA of simulatie actief is.

### Sensorwaarden injecteren

```
Topic:   chofu/sim/supply
Payload: float °C  (bereik -10 tot 80)
         leeg of "reset" → terug naar echte sensorwaarde

Topic:   chofu/sim/return
Payload: float °C  (bereik -10 tot 80)
         leeg of "reset" → terug naar echte sensorwaarde

Topic:   chofu/sim/outside
Payload: float °C  (bereik -30 tot 50)
         leeg of "reset" → terug naar echte sensorwaarde

Topic:   chofu/sim/water_setpoint
Payload: float °C  (bereik 16 tot 55)
         leeg of "reset" → terug naar waarde van chofu/cmd/water_setpoint

Topic:   chofu/sim/kamer
Payload: float °C  (bereik 5 tot 40)
         Overschrijft chofu/cmd/kamer in de PID-regeling.
         Gebruik dit in simulatie zodat de echte Zigbee-sensor
         (die ook naar chofu/cmd/kamer publiceert) niet interfereert.
         leeg of "reset" → terug naar chofu/cmd/kamer

Topic:   chofu/sim/kamer_gewenst
Payload: float °C  (bereik 14 tot 30)
         Overschrijft chofu/cmd/kamer_setpoint in de PID-regeling.
         leeg of "reset" → terug naar chofu/cmd/kamer_setpoint

Topic:   chofu/sim/reset
Payload: willekeurig
Effect:  Wist alle simulatiewaarden tegelijk
         (supply, return, outside, water_setpoint, kamer, kamer_gewenst)
```

### Testscenarios

```bash
BROKER="<YOUR_MQTT_BROKER_IP>"

# Noodstop aanvoer (SUPPLY_MAX = 60°C)
mosquitto_pub -h $BROKER -t "chofu/sim/supply" -m "65.0"
# Verwacht: stand=0, alert op chofu/alert

# Spike filter aanvoer (>10°C sprong)
mosquitto_pub -h $BROKER -t "chofu/sim/supply" -m "99.0"
# Verwacht: waarde verworpen, vorige waarde behouden, alert

# Koeling blokkering (buiten < 18°C)
mosquitto_pub -h $BROKER -t "chofu/cmd/koeling" -m "1"
mosquitto_pub -h $BROKER -t "chofu/sim/outside" -m "10.0"
# Verwacht: koeling=0, alert

# Stooklijn uit (auto modus, buiten > 18°C)
mosquitto_pub -h $BROKER -t "chofu/cmd/modus" -m "auto"
mosquitto_pub -h $BROKER -t "chofu/sim/outside" -m "20.0"
# Verwacht: stand=0, alert

# Vorstbeveiliging (buiten < T_VORST = 2°C)
mosquitto_pub -h $BROKER -t "chofu/sim/outside" -m "1.0"
# Verwacht: stand minimaal 1

# Water modus PID testen
mosquitto_pub -h $BROKER -t "chofu/cmd/modus" -m "water"
mosquitto_pub -h $BROKER -t "chofu/sim/water_setpoint" -m "40.0"
mosquitto_pub -h $BROKER -t "chofu/sim/supply" -m "35.0"
# Verwacht: PID verhoogt stand (5°C te koud → snelle hysteresis)
mosquitto_pub -h $BROKER -t "chofu/sim/supply" -m "42.0"
# Verwacht: PID verlaagt stand (te warm, maar binnen 1°C tolerantie)
mosquitto_pub -h $BROKER -t "chofu/sim/supply" -m "41.5"
# Verwacht: WP uit (>1°C boven setpoint)

# Koeling testen met sim setpoint
mosquitto_pub -h $BROKER -t "chofu/cmd/koeling" -m "1"
mosquitto_pub -h $BROKER -t "chofu/sim/water_setpoint" -m "18.0"
mosquitto_pub -h $BROKER -t "chofu/sim/supply" -m "20.0"
# Verwacht: PID verhoogt stand (te warm water bij koeling)

# Buiten sanity check
mosquitto_pub -h $BROKER -t "chofu/sim/outside" -m "99.0"
# Verwacht: waarde verworpen (buiten -30..+50 bereik), alert

# Simulatie resetten
mosquitto_pub -h $BROKER -t "chofu/sim/reset" -m "1"
# Verwacht: alle sim waarden weg, echte sensorwaarden actief
```

### Monitoring tijdens testen

```bash
# Alles tegelijk volgen
mosquitto_sub -h <YOUR_MQTT_BROKER_IP> -t "chofu/#" -v

# Alleen alerts en logs
mosquitto_sub -h <YOUR_MQTT_BROKER_IP> -t "chofu/alert" -v
mosquitto_sub -h <YOUR_MQTT_BROKER_IP> -t "chofu/log/#" -v
```

> **Let op:** Simulatiewaarden overleven geen herstart van de Arduino. Na een reset zijn alle sim waarden NAN (niet ingesteld) en worden echte sensorwaarden gebruikt.

---

## Simulatie Timing (Sneller-dan-realtime replay)

Voor het replay van historische tijdreeksen via een Python script kan de timing van de PID-regeling en hysteresis worden versneld via MQTT. Deze waarden worden **niet** in EEPROM opgeslagen — een herstart herstelt altijd de productiewaarden.

| Topic | Standaard | Eenheid | Beschrijving |
|---|---|---|---|
| `chofu/cmd/hyst_slow` | 600000 | ms | Hysteresis bij standverhoging (normaal: 10 min) |
| `chofu/cmd/hyst_fast` | 120000 | ms | Hysteresis bij grote fout >5°C (normaal: 2 min) |
| `chofu/cmd/hyst_down` |  60000 | ms | Hysteresis bij standverlaging water/ff_water (normaal: 1 min); auto/ff_auto gebruikt intern 5 min (AUTO_HYST_DOWN_MS) |
| `chofu/cmd/pid_interval` | 5000 | ms | PID berekeninterval (normaal: 5 sec) |

State topics (gepubliceerd elke 10 sec): `chofu/hyst_slow`, `chofu/hyst_fast`, `chofu/hyst_down`, `chofu/pid_interval`

Validatiebereiken: hyst_* 100–3.600.000 ms, pid_interval 100–60.000 ms.

### Python replay gebruik

```bash
# Versnelling instellen voor simulatie (bijv. 60x sneller: 1 min → 1 sec)
BROKER=<YOUR_MQTT_BROKER_IP>
mosquitto_pub -h $BROKER -t "chofu/cmd/hyst_slow"    -m "10000"   # 10 sec
mosquitto_pub -h $BROKER -t "chofu/cmd/hyst_fast"    -m "2000"    # 2 sec
mosquitto_pub -h $BROKER -t "chofu/cmd/hyst_down"    -m "1000"    # 1 sec
mosquitto_pub -h $BROKER -t "chofu/cmd/pid_interval" -m "83"      # ~1/60 van 5000ms

# Na simulatie: herstellen (of gewoon Arduino herstarten)
mosquitto_pub -h $BROKER -t "chofu/cmd/hyst_slow"    -m "600000"
mosquitto_pub -h $BROKER -t "chofu/cmd/hyst_fast"    -m "120000"
mosquitto_pub -h $BROKER -t "chofu/cmd/hyst_down"    -m "60000"
mosquitto_pub -h $BROKER -t "chofu/cmd/pid_interval" -m "5000"
```

> **Veiligheid:** Alle safeguards (SUPPLY_MAX, KOELING_MIN_BUITEN, vorstbeveiliging) blijven actief met versnelde timing. Alleen de schakelfrequentie neemt toe.

---

## Protocol Debug Topics

### Protocol logging

Zet protocol-logging aan om ruwe seriële frames in MQTT te zien. Handig bij het debuggen van hardware communicatie.

```
Topic:   chofu/cmd/proto_log
Payload: "1"  → aan
         "0"  → uit
State:   chofu/proto_log
```

Bij ingeschakelde logging worden ontvangen (rx) en verzonden (tx) frames gepubliceerd op:

| Topic | Beschrijving |
|---|---|
| `chofu/proto/tx` | Verzonden telegram (hex + decoded) |
| `chofu/proto/rx` | Ontvangen telegram (hex + decoded) |
| `chofu/proto/err` | Checksum-fout of ongeldig frame (CRC-CCITT residu ≠ 0) |

> De hex-dumps worden **uitgesteld** gepubliceerd (max 1 per seconde, buiten het tijdkritieke RX-pad) — een blokkerende MQTT-publish tijdens ontvangst verstoort anders de communicatie zelf.

Daarnaast verschijnt elke 30 s een samenvatting op `chofu/log/WARNING` (met proto_log aan altijd, anders alleen bij nieuwe fouten):
```
JGC (30s): CRC +x abort +y ok +z (totaal CRC/abort/ok)
```
Gezond: `ok` in de tientallen per 30 s, CRC en abort ~0.

### Protocol parser

De firmware gebruikt uitsluitend de **JGC multi-frame parser** (CRC-CCITT, variabele framelengte). De pomp antwoordt alleen op geldige JGC-polls; het oudere 25-byte formaat wordt genegeerd.

| Eigenschap | Waarde |
|---|---|
| Checksum | CRC-CCITT (0xFFFF, poly 0x1021), residu 0 |
| Frame-formaat | Lengte = lenbyte (12/13/18/20 bytes), 4 IDs, geen terminator |
| TX | 4 telegrammen roterend (tx0..tx3) |

> De "eindnul" per frame uit de oorspronkelijke JGC-code (Mega 2560) is een AVR-artefact: een lijn-break komt daar als databyte 0x00 binnen. De Renesas-UART van de UNO R4 filtert die weg; frames zijn exact `lenbyte` bytes. Zie [ervaringen.md](ervaringen.md).

**Diagnose:**
```bash
BROKER="<YOUR_MQTT_BROKER_IP>"

# Protocol logging aanzetten
mosquitto_pub -h $BROKER -t "chofu/cmd/proto_log" -m "1"

# Volg logs (RX-frames, TX-telegrammen, 30s-samenvatting)
mosquitto_sub -h $BROKER -t "chofu/proto/#" -v
mosquitto_sub -h $BROKER -t "chofu/log/#" -v
```

Voor diagnose op byte-niveau zonder WiFi/MQTT: flash `sniffer/sniffer.ino` (pollt zelf op 666 baud en dumpt alle bus-bytes als hex op USB-serial).

> **Baudrate:** De warmtepomp communiceert op **666 baud** (hardware UART Serial1, pins D0/D1).  
> **Serieel protocol:** Chofu 0x19 (commando) / 0x91 (status). Zie `WIRING.md` voor bekabeling.

---

## Plugwise Adam Topics

Alleen actief met `ADAM_IP`/`ADAM_PASS` in `config.h` én bron ≠ `uit`.
Zie [ADAM_INTEGRATIE_PLAN.md](ADAM_INTEGRATIE_PLAN.md) voor het volledige ontwerp.

### Commando's

```
Topic:   chofu/cmd/adam_bron          (EEPROM)
Payload: "uit"          → Adam niet gebruiken (default)
         "water"        → intended_boiler_temperature → t_water_gewenst
         "water+kamer"  → + temperatuur van ADAM_ZONE → t_kamer
         "multi"        → + regelen op zone met grootste vraag (setpoint − temp),
                          zonesetpoint vervangt Anna-setpoint; wissel-hysterese 0.3°C

Topic:   chofu/cmd/adam_koel_sp       (EEPROM)
Payload: 16.0 – 25.0    → watersetpoint bij Adam-koelvraag (default 18.0)
```

### Watersetpoint-interpretatie (water/ff_water)

| Adam SP | Betekenis | Actie |
|---|---|---|
| 0 | geen vraag | `t_water_gewenst = 0` → WP uit |
| 10 | koelvraag (Anna geeft vast 10°C) | koeling aan op `adam_koel_sp` (alleen ff_water) |
| ≥ 16 | verwarmingsvraag | `t_water_gewenst = SP` |

### State topics

| Topic | Inhoud |
|---|---|
| `chofu/adam/bron` | actieve bron |
| `chofu/adam/status` | `uit` / `init` (nog geen geslaagde poll) / `ok` / `fout` |
| `chofu/adam/sp` | laatste intended_boiler_temperature |
| `chofu/adam/koel_sp` | actueel koel-watersetpoint |
| `chofu/adam/zone/<naam>` | temperatuur per zone (naam gesaneerd, max 8) |
| `chofu/adam/zone/<naam>_sp` | thermostaatsetpoint per zone (indien aanwezig) |
| `chofu/adam/actieve_zone` | actieve zone in multi-modus |
| `chofu/adam/fout` | reden laatste mislukte poll: `verbinding mislukt`, `timeout <bytes>B st<state> http<code>`, `geen data (...)` — leeg = geen fout |

**Terugval:** API >90 s onbereikbaar → laatste MQTT-waarden gelden weer + alert; herstel wordt gelogd. De poll is niet-blokkerend (max 2048 bytes per loop-doorgang) en raakt de JGC-pomptiming niet.

**Implementatie:** per poll (30 s) twee gerichte requests i.p.v. het 200KB+ domain_objects-document — `/core/appliances;class=heater_central` (SP) en `/core/locations` (zones). Reden: de WiFiS3 stokt bij downloads > ~76 KB (zie ervaringen.md). Een bronwissel via `chofu/cmd/adam_bron` triggert direct een poll. Bediening en status zijn ook beschikbaar in de webinterface (tab "Adam").

---

## Kamertemperatuur Topics

| Topic | Richting | Beschrijving |
|---|---|---|
| `chofu/cmd/kamer_setpoint` | Thermostaat → Arduino | Gewenste kamertemperatuur (14–30°C) |
| `chofu/cmd/kamer` | Thermostaat/HA → Arduino | Werkelijke kamertemperatuur (5–35°C) |
| `chofu/cmd/kamer_in_water` | HA → Arduino | `1` = kamertemp gebruiken in ff_water (default); `0` = alleen aanvoertemp |

De waarde van `chofu/cmd/kamer` is ook rechtstreeks instelbaar via het **"Chofu Kamer"** number-entity in Home Assistant (verschijnt automatisch via discovery).

**`kamer_in_water` — ff_water zonder kamertemperatuur:**

Wanneer `kamer_in_water = 0` (of wanneer nog nooit een kamertemperatuur ontvangen is), werkt `ff_water` volledig op aanvoertemperatuur. De feedforward gebruikt dan buitentemperatuur als benadering voor P_nodig:

```
Verwarmen: P_nodig = UA_emitter × max(0, t_water_gewenst − t_outside)
Koelen:    P_nodig = UA_emitter × max(0, t_outside − t_water_gewenst)
```

De integraalcorrectie (op basis van aanvoer-regelafwijking) vangt de resterende modelfout op. Het online UA-leren wordt gepauzeerd zolang de kamertemperatuur niet beschikbaar is. Instelling wordt opgeslagen in EEPROM.

Voor automatische koppeling met een thermostaat: voeg onderstaande automatisering toe in HA zodat de thermostaat-waarden worden doorgestuurd naar de Arduino.

> **Simulatie:** Gebruik `chofu/sim/kamer` en `chofu/sim/kamer_gewenst` in plaats van de cmd-topics. Zo overschrijft de echte sensor de simulatiewaarden niet.

**Home Assistant Automatisering (optioneel — alleen nodig bij externe thermostaat):**
```yaml
automation:
  - alias: "Thermostaat Setpoint naar MQTT"
    trigger:
      platform: state
      entity_id: climate.anna
    action:
      service: mqtt.publish
      data:
        topic: "chofu/cmd/kamer_setpoint"
        payload: "{{ state_attr('climate.anna', 'temperature') }}"

  - alias: "Kamertemperatuur naar MQTT"
    trigger:
      platform: state
      entity_id: sensor.anna_temperature
    action:
      service: mqtt.publish
      data:
        topic: "chofu/cmd/kamer"
        payload: "{{ states('sensor.anna_temperature') }}"
```

---

## MQTT Explorer Structuur

```
chofu/
├── supply                   35.2
├── return                   30.1
├── outside                   8.5
├── delta_t                   5.1
├── kamer                    20.5
├── kamer_gewenst            21.0
├── stooklijn_basis                 28.0
├── doel_setpoint            34.8
├── water_setpoint           32.0
├── t_vorst                   2.0
├── stand                     3
├── vermogen                640
├── aan                       1
├── modus                ff_auto
├── koeling                   0
├── pid                      37.5
├── ff_ua_house             272.5
├── ff_ua_emitter           250.0
├── defrost                   0
├── pomp                     60
├── comp_hz                  45
├── lcd                       1
├── supply_max               60.0
├── koeling_min_buiten       18.0
├── stooklijn_uit            18.0
├── stooklijn_aan            16.0
├── sim_actief                0
├── proto_log                 0   ← protocol logging aan/uit
├── hyst_slow            600000   ← simulatie timing (niet EEPROM)
├── hyst_fast            120000
├── hyst_down             60000
├── pid_interval           5000
├── status                online   ← retained, LWT
├── alert          Verwarming gestopt: buiten 16.2C   ← retained
├── log/
│   ├── INFO             laatste event
│   └── WARNING          laatste waarschuwing
├── proto/
│   ├── tx               verzonden telegram (hex + decoded)
│   ├── rx               ontvangen telegram (hex + decoded)
│   └── err              checksum-fout of ongeldig frame
├── sim/
│   ├── supply              (schrijf alleen, geen state)
│   ├── return              (schrijf alleen, geen state)
│   ├── outside             (schrijf alleen, geen state)
│   ├── water_setpoint      (schrijf alleen, geen state)
│   ├── kamer               (schrijf alleen — overschrijft chofu/cmd/kamer)
│   ├── kamer_gewenst       (schrijf alleen — overschrijft chofu/cmd/kamer_setpoint)
│   └── reset               (schrijf alleen, geen state)
└── cmd/
    ├── modus
    ├── power
    ├── stand
    ├── water_setpoint
    ├── kamer_setpoint
    ├── koeling
    ├── stooklijn_basis
    ├── t_vorst
    ├── supply_max
    ├── koeling_min_buiten
    ├── stooklijn_uit
    ├── stooklijn_aan
    ├── stooklijn_grens
    ├── stooklijn_factor
    ├── kp / ki / kd
    ├── kp_water / ki_water / kd_water
    ├── ff_ua_house         ← FF leerwaarden
    ├── ff_ua_emitter
    ├── ff_save
    ├── lcd
    ├── force_start
    ├── proto_log           ← protocol logging aan/uit
    ├── hyst_slow           ← simulatie timing (niet EEPROM)
    ├── hyst_fast
    ├── hyst_down
    └── pid_interval
```

---

## Testing Met Mosquitto CLI

```bash
BROKER="<YOUR_MQTT_BROKER_IP>"

# Modus wisselen
mosquitto_pub -h $BROKER -t "chofu/cmd/modus" -m "auto"
mosquitto_pub -h $BROKER -t "chofu/cmd/modus" -m "water"
mosquitto_pub -h $BROKER -t "chofu/cmd/modus" -m "handmatig"

# Water modus instellen
mosquitto_pub -h $BROKER -t "chofu/cmd/water_setpoint" -m "45.0"

# Koeling inschakelen (alleen ff_auto, ff_water of handmatig)
mosquitto_pub -h $BROKER -t "chofu/cmd/modus" -m "ff_water"
mosquitto_pub -h $BROKER -t "chofu/cmd/water_setpoint" -m "18.0"
mosquitto_pub -h $BROKER -t "chofu/cmd/koeling" -m "1"

# Handmatige stand
mosquitto_pub -h $BROKER -t "chofu/cmd/stand" -m "4"   # 850W
mosquitto_pub -h $BROKER -t "chofu/cmd/stand" -m "0"   # uit

# Safeguard grenzen aanpassen
mosquitto_pub -h $BROKER -t "chofu/cmd/supply_max" -m "55.0"
mosquitto_pub -h $BROKER -t "chofu/cmd/koeling_min_buiten" -m "20.0"
mosquitto_pub -h $BROKER -t "chofu/cmd/stooklijn_uit" -m "18.0"

# Vorstgrens
mosquitto_pub -h $BROKER -t "chofu/cmd/t_vorst" -m "2.0"

# PID tuning
mosquitto_pub -h $BROKER -t "chofu/cmd/kp" -m "0.8"
mosquitto_pub -h $BROKER -t "chofu/cmd/ki" -m "0.01"
mosquitto_pub -h $BROKER -t "chofu/cmd/kd" -m "0.3"

# Force start (reset hysteresis)
mosquitto_pub -h $BROKER -t "chofu/cmd/force_start" -m "1"

# Anna simuleren
mosquitto_pub -h $BROKER -t "chofu/cmd/kamer_setpoint" -m "21.0"
mosquitto_pub -h $BROKER -t "chofu/cmd/kamer" -m "20.3"

# Monitoring
mosquitto_sub -h $BROKER -t "chofu/#" -v
mosquitto_sub -h $BROKER -t "chofu/log/#" -v
mosquitto_sub -h $BROKER -t "chofu/alert" -v
```

---

## Troubleshooting

### Entiteiten niet zichtbaar in HA

```
1. Wacht 2 minuten na herstart Arduino (discovery in 3 fases)
2. Check MQTT Explorer: zijn chofu/* topics aanwezig?
3. Check homeassistant/sensor/chofu_hp/supply/config: is er JSON?
4. HA → Settings → Devices & Services → MQTT → Reload
5. Verwijder device in HA en wacht op herdetectie
```

### Entiteiten "niet beschikbaar"

```
Check chofu/status in MQTT Explorer:
- "online"  → Arduino verbonden, probleem elders
- "offline" → LWT getriggerd (Arduino weg of crash)
- leeg      → Arduino heeft nog niet gepubliceerd
```

### Alert sensor toont oude melding

```
chofu/alert is retained → bevat altijd laatste bericht.
Wis handmatig via MQTT Explorer (leeg bericht sturen)
of wacht op volgende alert.
```

### Commando's werken niet

```
1. mosquitto_pub -h <YOUR_MQTT_BROKER_IP> -t "chofu/cmd/modus" -m "auto"
2. Check Serial monitor: toont "MQTT: chofu/cmd/modus=auto"
3. Als niks: Arduino niet verbonden met broker
```

---

## EEPROM Opslag

Volgende parameters blijven bewaard na herstart:

| Parameter | Default | Commando |
|---|---|---|
| Stooklijn Basis | 28.0°C | `chofu/cmd/stooklijn_basis` |
| Kp (auto) | 75.0 | `chofu/cmd/kp` |
| Ki (auto) | 0.800 | `chofu/cmd/ki` |
| Kd (auto) | 0.010 | `chofu/cmd/kd` |
| Kp (water) | 50.0 | `chofu/cmd/kp_water` |
| Ki (water) | 0.800 | `chofu/cmd/ki_water` |
| Kd (water) | 0.010 | `chofu/cmd/kd_water` |
| Stooklijn grens | 15.0°C | `chofu/cmd/stooklijn_grens` |
| Stooklijn factor | 0.68 | `chofu/cmd/stooklijn_factor` |
| T_VORST | 2.0°C | `chofu/cmd/t_vorst` |
| SUPPLY_MAX | 60.0°C | `chofu/cmd/supply_max` |
| KOELING_MIN_BUITEN | 18.0°C | `chofu/cmd/koeling_min_buiten` |
| SUPPLY_MIN | 17.0°C | `chofu/cmd/supply_min` |
| STOOKLIJN_UIT | 18.0°C | `chofu/cmd/stooklijn_uit` |
| STOOKLIJN_AAN | 16.0°C | `chofu/cmd/stooklijn_aan` |
| FF UA_house | 272.5 W/K | `chofu/cmd/ff_ua_house` |
| FF UA_emitter | 250.0 W/K | `chofu/cmd/ff_ua_emitter` |
| Modus | auto | `chofu/cmd/modus` |

---

*Zie ook: [README.md](README.md) — Projectoverzicht en installatie*
