jaapschellekens/aurea5-chofu-ctrl/chofu_wp_ff/chofu_wp_ff.ino

/*
 * ╔═══════════════════════════════════════════════════════════════╗
 * ║  ChofuCtrl v2.0 — FF modus                                  ║
 * ╚═══════════════════════════════════════════════════════════════╝
 *
 * Arduino UNO R4 WiFi
 * Chofu AEYC-0643XU-CH Warmtepomp + Atlantic Aurea Controlbox
 *
 * Nieuw t.o.v. v1.0:
 *   "ff_auto"  — Feedforward op kamertemperatuur
 *                Onderhoudstand = UA_house_est × (T_set − T_buiten) / COP
 *                Leert UA_house online uit P_hp / (T_kamer − T_buiten)
 *
 *   "ff_water" — Feedforward op aanvoertemperatuur (extern setpoint Adam)
 *                Onderhoudstand via P_house / COP_op_T_supply_nodig
 *                Leert UA_emitter online uit P_hp / (T_aanvoer − T_kamer)
 *                Geen oscillatie door breed doodsband (−1.5°C) + hyst 10 min
 *
 *   Leerwaarden (ff_UA_house, ff_UA_emitter) worden in EEPROM opgeslagen
 *   zodat de gecalibreerde waarden een herstart overleven.
 *
 * Bestaande modi blijven ongewijzigd:
 *   "auto"      — Kamer PID (t_supply → stooklijn setpoint)
 *   "water"     — Aanvoer PID (t_supply → t_water_gewenst)
 *   "handmatig" — Vaste stand
 */

// WiFi & MQTT — credentials staan in config.h (niet in git)
#include "config.h"

// Typen, structs en constanten
#include "types.h"

// Globale variabelen (extern declaraties + library-includes)
#include "globals.h"

// Modules
#include "eeprom.h"
#include "protocol.h"
#include "regelaar.h"
#include "mqtt.h"
#include "display.h"
#include "web.h"
#include "knoppen.h"
#include "adam.h"
#include "ot.h"

// ═══════════════════════════════════════════════════════════════
//  SETUP
// ═══════════════════════════════════════════════════════════════

void setup(){
  Serial.begin(115200);
  delay(2000);
  Serial.println("\n\nChofuCtrl v2.0 — FF modus");
  EEPROM_BEGIN();
  eeprom_init();
#if defined(ADAM_IP)
  #ifndef ADAM_ZONE
    #define ADAM_ZONE ""
  #endif
  adam_config(ADAM_IP, ADAM_PASS, ADAM_ZONE);
  Serial.println("Adam API geconfigureerd: " ADAM_IP);
#endif
#if defined(OT_RX_PIN)
  #ifndef OT_TX_PIN
    #define OT_TX_PIN 9
  #endif
  ot_config(OT_RX_PIN, OT_TX_PIN);
  Serial.println("OT-link (RX-only) op pin " + String(OT_RX_PIN));
#endif
  knoppen_init();
  // SWW driewegklep-relais: uitgang, klep dicht bij start
  pinMode(SWW_KLEP_PIN, OUTPUT);
  digitalWrite(SWW_KLEP_PIN, SWW_KLEP_ACTIEF_HOOG ? LOW : HIGH);
#if defined(ARDUINO_UNOR4_WIFI)
  chofuSerial.begin(666);
#else
  chofuSerial.begin(666, SERIAL_8N1, CHOFU_RX_PIN, CHOFU_TX_PIN);
#endif

  if(USE_LCD){
    lcd.init(); lcd.init(); lcd.backlight();
    lcd.print("ChofuCtrl"); lcd.setCursor(0,1); lcd.print("v2.0 FF");
    delay(2000);
  }

  #if USE_LCD
  lcd.clear(); lcd.print("WiFi...");
  #endif
  WiFi.begin(SSID, PASS);
#if !defined(ARDUINO_UNOR4_WIFI)
  // ESP32: modem-sleep (power save) UIT — anders wordt het bord na enkele
  // minuten onbereikbaar (verbinding/webserver valt weg). Plus auto-reconnect.
  WiFi.setSleep(false);
  WiFi.setAutoReconnect(true);
#endif
  int attempts = 0;
  while(WiFi.status() != WL_CONNECTED && attempts < 20){ Serial.print("."); delay(500); attempts++; }
  if(WiFi.status() == WL_CONNECTED){
    while(WiFi.localIP() == IPAddress(0,0,0,0) && attempts < 30){ delay(1000); attempts++; }
    Serial.print("WiFi OK! IP: "); Serial.println(WiFi.localIP());
    #if USE_LCD
    lcd.clear(); lcd.print("WiFi OK!"); lcd.setCursor(0,1); lcd.print(WiFi.localIP());
    delay(2000);
    #endif
  }

  webServer.begin();
  #if USE_LCD
  lcd.clear(); lcd.print("MQTT...");
  #endif
  Serial.print("MQTT: verbinden met "); Serial.print(MQTT_BROKER);
  Serial.print(":"); Serial.println(MQTT_PORT);
  Serial.print("MQTT: gebruiker="); Serial.println(MQTT_USER);
  mqttClient.setUsernamePassword(MQTT_USER, MQTT_PASS);
  mqttClient.setId(HA_NODE);   // unieke client-ID per device — voorkomt reconnect-storm bij testbord naast productie
  mqttClient.onMessage(mqtt_ontvang);
  Serial.println("MQTT: LWT instellen (" MQTT_PREFIX "/status = offline)");
  mqttClient.beginWill(MQTT_PREFIX "/status", true, 1);
  mqttClient.print("offline");
  mqttClient.endWill();

  Serial.println("MQTT: connect()...");
  wifiClient.stop();   // ruim een eventueel hangende socket op (na reset/reflash)
  if(mqttClient.connect(MQTT_BROKER, MQTT_PORT)){
    Serial.println("MQTT OK!");
    Serial.println("MQTT: abonneren op " MQTT_PREFIX "/cmd/#, " MQTT_PREFIX "/sim/#");
    mqttClient.subscribe(MQTT_PREFIX "/cmd/#");
    mqttClient.subscribe(MQTT_PREFIX "/sim/#");
    Serial.println("MQTT: publiceren " MQTT_PREFIX "/status = online");
    mqttClient.beginMessage(MQTT_PREFIX "/status", true, 1);
    mqttClient.print("online");
    mqttClient.endMessage();
    delay(1000);
    #if USE_LCD
    lcd.clear(); lcd.print("Discovery...");
    #endif
    discovery_fase1();
    vorige_discovery_ms = millis();
    discovery_fase = 1;
  } else {
    Serial.print("MQTT: verbinding mislukt, foutcode="); Serial.println(mqttClient.connectError());
  }

  Serial.println("Systeem operationeel");
  Serial.print("Web: http://"); Serial.println(WiFi.localIP());
#if defined(ARDUINO_UNOR4_WIFI)
  // matrix.begin() MOET na WiFi.begin() komen: de WiFi-library reset op de UNO R4
  // bepaalde hardware-timers waardoor de ISR van de LED-matrix stopt.
  if(USE_LED_MATRIX){
    bool ok = matrix.begin();
    Serial.print("LED matrix begin(): "); Serial.println(ok ? "OK" : "MISLUKT");
  }
#endif
  boot_ms = millis();
  Serial.println("Koude-start vertraging: 5 min stand=0");
}

// ═══════════════════════════════════════════════════════════════
//  MAIN LOOP
// ═══════════════════════════════════════════════════════════════

void mqtt_herverbind(){
  // Snelpad: alles in orde → meteen terug.
  if(WiFi.status() == WL_CONNECTED && mqttClient.connected()) return;

  // Niet-blokkerende backoff: hooguit 1 herstelpoging per RECONNECT_MS, zodat de
  // regelaar/JGC-loop niet stilvalt (geen delay() meer in het pad).
  static uint32_t laatste_poging_ms = 0;
  const uint32_t RECONNECT_MS = 5000;
  if(laatste_poging_ms != 0 && millis() - laatste_poging_ms < RECONNECT_MS) return;
  laatste_poging_ms = millis();

  // WiFi eerst: MQTT kan niet werken zonder WiFi
  if(WiFi.status() != WL_CONNECTED){
    Serial.println("WiFi: herverbinden...");
    WiFi.disconnect();
    WiFi.begin(SSID, PASS);
#if !defined(ARDUINO_UNOR4_WIFI)
    WiFi.setSleep(false);   // power save opnieuw uitzetten na reconnect
#endif
    uint32_t t = millis();
    while(WiFi.status() != WL_CONNECTED && millis() - t < 10000) delay(500);
    if(WiFi.status() != WL_CONNECTED){
      Serial.println("WiFi: herverbinden mislukt");
      return;
    }
    Serial.print("WiFi: herverbonden, IP: "); Serial.println(WiFi.localIP());
  }

  if(mqttClient.connected()) return;

  // Oude TCP-socket expliciet sluiten vóór een nieuwe poging — voorkomt een
  // blijvende 'connection refused' (-2) door een hangende socket na reset/drop
  // (zowel UNO R4 WiFiS3 als ESP32).
  wifiClient.stop();

  Serial.print("MQTT: herverbinden met "); Serial.print(MQTT_BROKER);
  Serial.print(":"); Serial.println(MQTT_PORT);
  mqttClient.beginWill(MQTT_PREFIX "/status", true, 1);
  mqttClient.print("offline");
  mqttClient.endWill();
  if(mqttClient.connect(MQTT_BROKER, MQTT_PORT)){
    Serial.println("MQTT: herverbonden");
    mqttClient.subscribe(MQTT_PREFIX "/cmd/#");
    mqttClient.subscribe(MQTT_PREFIX "/sim/#");
    mqttClient.beginMessage(MQTT_PREFIX "/status", true, 1);
    mqttClient.print("online");
    mqttClient.endMessage();
    discovery_fase = 0; discovery_fase1();
    vorige_discovery_ms = millis(); discovery_fase = 1;
  } else {
    Serial.print("MQTT: herverbinden mislukt, foutcode="); Serial.println(mqttClient.connectError());
  }
}

void loop(){
  mqtt_herverbind();
  mqttClient.poll();
  check_knoppen();
  check_mqtt_watchdog();

  // Koude-start vertraging: eerste 5 min na boot altijd stand=0
  static bool boot_delay_afgelopen = false;
  if(!boot_delay_afgelopen){
    if(millis() - boot_ms < BOOT_DELAY_MS){
      ctrl.stand = 0;
      ctrl.wp_aan = false;
    } else {
      boot_delay_afgelopen = true;
      mqtt_log("Koude-start vertraging afgelopen — regelaar actief", "INFO");
    }
  }

  lees_warmtepomp_data();
  adam_poll();      // niet-blokkerend; doet zelf zijn 30s-timing
  ot_poll();        // OT-link RX-only (fase 1, experimenteel)
  adam_pas_toe();   // vóór pas_sim_toe zodat de simulator altijd wint
  pas_sim_toe();
  pas_pid_aan();
  // Configureerbare max compressorstand — geldt in alle modi behalve handmatig.
  // Niet tijdens SWW: tapwater heeft een eigen limiet (SWW_MAX_STAND).
  if(!sww_actief && modus != Modus::HANDMATIG && ctrl.stand > MAX_STAND){
    ctrl.stand = MAX_STAND;
    ctrl.wp_aan = (ctrl.stand > 0);
  }
  update_lcd();
  update_matrix();
#if defined(ARDUINO_UNOR4_WIFI)
  // loadFrame() hier aanroepen (zelfde TU als ISR) zodat de juiste 'framebuffer'
  // static variabele wordt bijgewerkt. display.cpp heeft een eigen kopie.
  if(USE_LED_MATRIX && matrix_fb_klaar){
    matrix_fb_klaar = false;
    matrix.loadFrame(matrix_fb);
  }
#endif
  if(data_sturen_gevraagd || millis() - vorige_data_ms > 10000){
    data_sturen_gevraagd = false;
    stuur_data();
  }
  // Serial-log batched naar MQTT (alleen indien aan), buiten het JGC-RX-pad.
  static uint32_t vorige_seriallog_ms = 0;
  if(seriallog_enabled && millis() - vorige_seriallog_ms > 30000){
    vorige_seriallog_ms = millis();
    seriallog_flush();
  }
  if(discovery_fase == 1 && millis() - vorige_discovery_ms > 30000){
    discovery_fase2(); vorige_discovery_ms = millis(); discovery_fase = 2;
  }
  if(discovery_fase == 2 && millis() - vorige_discovery_ms > 30000){
    discovery_fase3(); discovery_fase = 3;
  }
  handle_web_client();
  delay(10);
}
