jaapschellekens/aurea5-chofu-ctrl/chofu_wp_ff/globals.cpp

#include "globals.h"

// ═══════════════════════════════════════════════════════════════
//  HARDWARE OBJECTEN
// ═══════════════════════════════════════════════════════════════

HardwareSerial&   chofuSerial = Serial1;
WiFiClient        wifiClient;
MqttClient        mqttClient(wifiClient);
LiquidCrystal_I2C lcd(0x27, 16, 2);
#if defined(ARDUINO_UNOR4_WIFI)
ArduinoLEDMatrix  matrix;
#endif
WiFiServer webServer(80);

// ═══════════════════════════════════════════════════════════════
//  WARMTEPOMP DATA
// ═══════════════════════════════════════════════════════════════

float   t_supply = 25.0, t_return = 20.0, t_outside = 5.0;
uint8_t wp_stroom_raw = 0;
uint8_t wp_vermogen_raw = 0;
bool    defrost = false;
float   werkelijk_vermogen_w = 0;
float   comp_hz = NAN, t_persgas = NAN, t_verdamper = NAN, t_zuiggas = NAN, t_d4 = NAN;
bool    comp_vrijgave = false;
bool    circ_pomp = false;
uint8_t wp_alarm[4] = {0};

// ═══════════════════════════════════════════════════════════════
//  KAMER / WATER
// ═══════════════════════════════════════════════════════════════

float t_kamer = 19.0;
float t_kamer_gewenst = 19.0;
float t_water_gewenst = 32.0;
bool  koeling_modus = false;
bool  kamer_geldig = false;    // false tot eerste ontvangst via chofu/cmd/kamer
bool  kamer_in_water = true;   // default: kamertemp gebruiken in ff_water (zoals voorheen)

// ═══════════════════════════════════════════════════════════════
//  REGELPARAMETERS
// ═══════════════════════════════════════════════════════════════

float   setpoint = 28.0;
float   doel_setpoint = 40.0;
uint8_t MAX_STAND = 8;   // default = ongelimiteerd (regelaar gaat in niet-handmatig nooit boven 8)

bool    sww_actief    = false;
float   SWW_SETPOINT  = 50.0;   // tapwater laad-aanvoertemperatuur
uint8_t SWW_MAX_STAND = 8;      // tapwater mag op volle stand laden
float   delta_t = 5.0;
bool    lcd_enabled = true;
Modus   modus = Modus::AUTO;
uint8_t handmatig_stand = 1;

float Kp = 75.0;    // auto modus — geoptimaliseerd KGE (was 19.9)
float Ki = 0.800;   // auto modus — geoptimaliseerd KGE (was 0.084)
float Kd = 0.010;   // auto modus — geoptimaliseerd KGE (was 0.036)

// PID water modus: hogere Kp nodig voor aanvoer-tracking; lage Kd (minder switching)
float Kp_water = 50.0;   // water modus — geoptimaliseerd KGE (stooklijn als setpoint)
float Ki_water = 0.800;  // water modus — geoptimaliseerd KGE (stooklijn als setpoint)
float Kd_water = 0.010;  // water modus — geoptimaliseerd KGE (stooklijn als setpoint)

long HYST_SLOW_MS = 600000;  // 10 minuten
long HYST_FAST_MS = 120000;  //  2 minuten
long HYST_DOWN_MS =  60000;  //  1 minuut
long pid_interval_ms = 5000; //  5 seconden

float STOOKLIJN_GRENS  = 15.0;
float STOOKLIJN_FACTOR = 0.68;
float T_VORST          = 2.0;

float SUPPLY_MAX           = 60.0;
float SUPPLY_MIN           = 17.0;  // condensatiebescherming koeling (°C)
float WATER_SP_MIN         = 16.0;  // minimaal geldig water setpoint (°C); 1–(min-1) wordt genegeerd
float KOELING_MIN_BUITEN   = 18.0;
float KOELING_AFSCHAKEL    = 0.5f;  // °C ónder setpoint → koeling terugschakelen (niet EEPROM)
float KOEL_DEADBAND        = 1.0f;  // °C koel-doodband: geen opschaling binnen deze mismatch
float STOOKLIJN_UIT_GRENS  = 18.0;  // WP uit bij >18°C buiten (huis heeft dan nog ~500W warmtevraag)
float STOOKLIJN_AAN_GRENS  = 16.0;  // aan bij <16°C (2°C hysteresis)
long  FF_MIN_OFF_MS        = 600000L;  // 10 min min. uitschakelperiode na thermische stop
float FF_RESTART_COAST     = 0.20f;    // °C onder setpoint vereist voor herstart vanuit stand 0
long  AUTO_HYST_DOWN_MS    = 300000L;  // 5 min — trager afbouwen in AUTO dan water (1 min)
float FF_AFSCHAKEL_AUTO    = -0.5f;    // °C kamer boven setpoint → FF begint terug te schakelen
long  FF_LOOKAHEAD_MS      = 300000L;  // 5 min vooruitkijken voor predictieve terugschakeling
long  FF_THERMAL_MIN_OFF_MS = 60000L;  // 1 min min. uitschakelperiode na thermische stop (vs 10 min seizoen)
long  MQTT_WATCHDOG_MS     = 7200000;

float ff_UA_house   = 272.5;  // [W/K] lerende UA huis  — geoptimaliseerd KGE
float ff_UA_emitter = 250.0;  // [W/K] lerende UA emitter — bijgesteld na sim-analyse (was 267.5)

// ═══════════════════════════════════════════════════════════════
//  CONTROLLER TOESTAND
// ═══════════════════════════════════════════════════════════════

ControllerState ctrl;

// ═══════════════════════════════════════════════════════════════
//  PROTOCOL BUFFERS
// ═══════════════════════════════════════════════════════════════

uint8_t telegram_buffer[25];
uint8_t buffer_index = 0;

float prev_t_supply  = 25.0;
float prev_t_return  = 20.0;
float prev_t_outside =  5.0;

// ═══════════════════════════════════════════════════════════════
//  SIMULATIE
// ═══════════════════════════════════════════════════════════════

float sim_t_supply        = NAN;
float sim_t_return        = NAN;
float sim_t_outside       = NAN;
float sim_t_water_gewenst = NAN;
float sim_t_kamer         = NAN;
float sim_t_kamer_gewenst = NAN;
bool  sim_enabled         = false;
bool  proto_logging       = false;  // schakelbaar via chofu/cmd/proto_log
uint16_t proto_crc_fouten = 0;      // teller checksum/CRC fouten

// ═══════════════════════════════════════════════════════════════
//  TIMERS
// ═══════════════════════════════════════════════════════════════

uint8_t  discovery_fase = 0;
uint32_t vorige_discovery_ms = 0;
uint32_t vorige_data_ms = 0;
uint32_t vorige_lcd_ms = 0;
uint32_t vorige_matrix_ms = 0;
uint8_t  matrix_pagina = 0;
uint32_t matrix_fb[3]  = {0, 0, 0};
bool     matrix_fb_klaar = false;
uint32_t vorige_pid_ms = 0;
uint32_t vorige_telegram_ms = 0;
uint32_t vorige_web_check_ms = 0;
uint32_t vorige_mqtt_rx_ms = 0;
uint32_t boot_ms = 0;

// ═══════════════════════════════════════════════════════════════
//  MQTT LOGGING STATE
// ═══════════════════════════════════════════════════════════════

bool     mqtt_logging_enabled = true;
bool     seriallog_enabled = false;   // default uit (kost RAM/bandbreedte)
uint32_t laatste_log_ms = 0;
bool     data_sturen_gevraagd = false;
