jaapschellekens/aurea5-chofu-ctrl/chofu_wp_ff/globals.h

#ifndef CHOFU_GLOBALS_H
#define CHOFU_GLOBALS_H

#if defined(ARDUINO_UNOR4_WIFI)
  #include <WiFiS3.h>
  #include <Arduino_LED_Matrix.h>
#else
  #include <WiFi.h>
#endif
#include <ArduinoMqttClient.h>
#include <LiquidCrystal_I2C.h>
#if defined(ARDUINO_UNOR4_WIFI)
  #include <EEPROM.h>
#endif

#include "types.h"

// ═══════════════════════════════════════════════════════════════
//  HARDWARE OBJECTEN
// ═══════════════════════════════════════════════════════════════

extern HardwareSerial&   chofuSerial;
extern WiFiClient        wifiClient;
extern MqttClient        mqttClient;
extern LiquidCrystal_I2C lcd;
#if defined(ARDUINO_UNOR4_WIFI)
extern ArduinoLEDMatrix  matrix;
#endif
extern WiFiServer webServer;

// ═══════════════════════════════════════════════════════════════
//  WARMTEPOMP DATA
// ═══════════════════════════════════════════════════════════════

extern float   t_supply, t_return, t_outside;
extern uint8_t wp_stroom_raw;        // frame 91-3 byte 9: stroom (display d3 = raw/5; eenheid niet bewezen)
extern uint8_t wp_vermogen_raw;      // frame 91-3 byte 10: compressorvermogen / 25.6
extern bool    defrost;
extern float   werkelijk_vermogen_w;
// Extra pompwaarden (zie docs/extra-comm-info.txt). NAN = nog niet ontvangen.
extern float   comp_hz;              // 91-3 b3 × 2/3 (display d1)
extern float   t_persgas;            // 91-2 b13 pagina 0, °C direct (d2)
extern float   t_verdamper;          // 91-2 b11 pagina 0, raw/2 − 41 (d5)
extern float   t_zuiggas;            // 91-2 b12 pagina 0, raw/2 − 41 (d8)
extern float   t_d4;                 // 91-2 b14 pagina 0, raw/2 − 41 (d4, waterzijde)
extern bool    comp_vrijgave;        // 91-1 b9 != 0 (0x8A = compressor mag draaien)
extern bool    circ_pomp;            // 91-3 b13 > 100 (24 = uit, ~152 = aan)
extern uint8_t wp_alarm[4];          // 91-1 b5..8, normaal altijd 0

// ═══════════════════════════════════════════════════════════════
//  KAMER / WATER
// ═══════════════════════════════════════════════════════════════

extern float t_kamer;
extern float t_kamer_gewenst;
extern float t_water_gewenst;
extern bool  koeling_modus;
extern bool  kamer_geldig;       // true zodra chofu/cmd/kamer ten minste 1x ontvangen is
extern bool  kamer_in_water;     // true = kamertemp gebruiken in ff_water/water; false = alleen aanvoertemp

// ═══════════════════════════════════════════════════════════════
//  REGELPARAMETERS (instelbaar via MQTT, opgeslagen in EEPROM)
// ═══════════════════════════════════════════════════════════════

extern float   setpoint;
extern float   doel_setpoint;
extern uint8_t MAX_STAND;   // max compressorstand in alle modi behalve HANDMATIG (1–8)

// SWW (tapwater) — overlay-modus, overschrijft de actieve regeling tijdelijk
extern bool    sww_actief;     // door HA gezet via chofu/cmd/sww
extern float   SWW_SETPOINT;   // gewenste aanvoertemp tijdens tapwater laden (°C)
extern uint8_t SWW_MAX_STAND;  // max compressorstand tijdens SWW (eigen limiet, los van MAX_STAND)
extern float   delta_t;
extern bool    lcd_enabled;
extern Modus   modus;
extern uint8_t handmatig_stand;

// PID (auto modus: aanvoer vs stooklijn setpoint)
extern float Kp, Ki, Kd;

// PID water modus (aanvoer vs vaste water setpoint — apart geoptimaliseerd)
extern float Kp_water, Ki_water, Kd_water;

// Hysteresis tijden
extern long HYST_SLOW_MS;
extern long HYST_FAST_MS;
extern long HYST_DOWN_MS;
extern long pid_interval_ms;

// Stooklijn
extern float STOOKLIJN_GRENS;
extern float STOOKLIJN_FACTOR;
extern float T_VORST;

// Safeguards
extern float SUPPLY_MAX;
extern float SUPPLY_MIN;
extern float WATER_SP_MIN;        // minimaal geldig water setpoint (16°C default; 0 = geen warmtevraag altijd geldig)
extern float KOELING_MIN_BUITEN;
extern float KOELING_AFSCHAKEL;
extern float KOEL_DEADBAND;        // °C: koel-mismatch waarbinnen niet wordt opgeschaald
extern float STOOKLIJN_UIT_GRENS;
extern float STOOKLIJN_AAN_GRENS;  // aan-drempel na buitenseizoen: hysteresis t.o.v. UIT_GRENS
extern long  FF_MIN_OFF_MS;         // min uitschakelperiode na thermische stop (ms)
extern float FF_RESTART_COAST;      // °C onder setpoint vereist voor herstart vanuit stand 0
extern long  AUTO_HYST_DOWN_MS;     // ms — hysteresis bij afbouwen in AUTO (water=HYST_DOWN_MS)
extern float FF_AFSCHAKEL_AUTO;     // °C fout waarbij FF begint terug te schakelen (auto modus)
extern long  FF_LOOKAHEAD_MS;       // ms vooruitkijken voor predictieve terugschakeling (default 300s)
extern long  FF_THERMAL_MIN_OFF_MS; // min uitschakelperiode na thermische stop (korter dan seizoensstop)
extern long  MQTT_WATCHDOG_MS;

// FF leerwaarden (instelbaar via MQTT, opgeslagen in EEPROM)
extern float ff_UA_house;
extern float ff_UA_emitter;

// ═══════════════════════════════════════════════════════════════
//  CONTROLLER TOESTAND
// ═══════════════════════════════════════════════════════════════

extern ControllerState ctrl;

// ═══════════════════════════════════════════════════════════════
//  PROTOCOL BUFFERS
// ═══════════════════════════════════════════════════════════════

extern uint8_t telegram_buffer[25];
extern uint8_t buffer_index;

// Spike filter (vorige waarden voor plausibiliteitscheck)
extern float prev_t_supply;
extern float prev_t_return;
extern float prev_t_outside;

// ═══════════════════════════════════════════════════════════════
//  SIMULATIE
// ═══════════════════════════════════════════════════════════════

extern float sim_t_supply;
extern float sim_t_return;
extern float sim_t_outside;
extern float sim_t_water_gewenst;
extern float sim_t_kamer;
extern float sim_t_kamer_gewenst;
extern bool  sim_enabled;
extern bool  proto_logging;
extern uint16_t proto_crc_fouten; // teller CRC/checksum fouten

inline bool sim_actief(){
  return sim_enabled &&
        (!isnan(sim_t_supply) || !isnan(sim_t_return) || !isnan(sim_t_outside)
      || !isnan(sim_t_water_gewenst) || !isnan(sim_t_kamer));
}

// ═══════════════════════════════════════════════════════════════
//  TIMERS
// ═══════════════════════════════════════════════════════════════

extern uint8_t  discovery_fase;
extern uint32_t vorige_discovery_ms;
extern uint32_t vorige_data_ms;
extern uint32_t vorige_lcd_ms;
extern uint32_t vorige_matrix_ms;
extern uint8_t  matrix_pagina;
// Berekend frame voor de LED matrix — wordt door update_matrix() gevuld en door
// de .ino via matrix.loadFrame() naar de ISR gestuurd (zelfde translation unit als ISR).
extern uint32_t matrix_fb[3];
extern bool     matrix_fb_klaar;
extern uint32_t vorige_pid_ms;
extern uint32_t vorige_telegram_ms;
extern uint32_t vorige_web_check_ms;
extern uint32_t vorige_mqtt_rx_ms;
extern uint32_t boot_ms;            // tijdstip einde setup() — voor koude-start vertraging

constexpr uint32_t BOOT_DELAY_MS = 300000UL; // 5 min: WP op stand 0 na koude start

// ═══════════════════════════════════════════════════════════════
//  MQTT LOGGING
// ═══════════════════════════════════════════════════════════════

extern bool     mqtt_logging_enabled;
extern bool     seriallog_enabled;   // batched serial-log naar chofu/seriallog (1×/30s)
extern uint32_t laatste_log_ms;

// Vlag: stuur_data() is aangevraagd vanuit de MQTT-callback maar wordt
// afgehandeld in de main loop om re-entrant gebruik van mqttClient te voorkomen.
extern bool     data_sturen_gevraagd;

constexpr uint32_t LOG_THROTTLE_MS = 500;
#endif // CHOFU_GLOBALS_H
