jaapschellekens/aurea5-chofu-ctrl/(commit log)

2026-05-05 lots of stuff removed and lots added
    [pid_params_optimaal.json]
2026-05-07 Expand copilot-instructions with heating curve documentation
2026-05-07 Add docs/HEATING_CURVE.md — heating curve explanation for all control modes
2026-05-07 Rename HEATING_CURVE → STOOKLIJN.md, rewrite in Dutch, correct FF_WATER/FF_AUTO behavior
    - FF_WATER now follows externally set Adam water setpoint
    - FF_AUTO now uses the heating curve as its supply target
    - Add language preference (Dutch) to skill file
2026-05-08 Refactor: sketch opgesplitst in .h/.cpp modules
    Monolithische chofu_wp_ff.ino (1502 regels) opgedeeld in aparte modules:
    - types.h — Modus enum, ControllerState struct, FF-constanten
    - globals.h/.cpp — library-includes + definities van alle globals
    - eeprom.h/.cpp — EEPROM init/save/load
    - protocol.h/.cpp — WP-serieel protocol + simulator-toepassing
    - regelaar.h/.cpp — FF-regelaar + PID
    - mqtt.h/.cpp — logging, watchdog, discovery, stuur_data
    - display.h/.cpp — LCD + LED matrix
    - web.h/.cpp — webinterface
    Hoofdsketch bevat nu alleen setup(), loop() en mqtt_herverbind() (~168 regels).
2026-05-10 Koelmodus: FF-regelaar voor FF_AUTO, FF_WATER en HANDMATIG
    - Nieuwe FF koelregelaar (pas_ff_koel_aan): feedforward op basis van
    UA_house (ff_auto) of UA_emitter (ff_water), met condensatiebescherming,
    herstart-hysteresis en integraalcorrectie
    - Koeling alleen toegestaan in ff_auto, ff_water en handmatig;
    geblokkeerd in auto en water met alert
    - ff_cop_koel(): COP formule voor koeling (T_supply / (T_buiten - T_supply) × 0.40)
    - SUPPLY_MIN (17.0°C, EEPROM) en KOELING_AFSCHAKEL (0.5°C) toegevoegd
    - EEPROM_MAGIC 0xB2 → 0xB3, ADDR_SUPPLY_MIN = 66
    - MQTT: supply_min en koeling_afschakel cmd/state handlers
    - HA autodiscovery: Chofu Doel Setpoint (sensor), Chofu Koeling Aanvoer Min,
    Cho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
2026-05-10 WIRING: 28-pins IC voetje toegevoegd aan BOM
2026-05-10 INSTALLATION: pin 2/3 gecorrigeerd naar D0/D1 (Serial1)
    SoftwareSerial op pin 2/3 crasht de WiFi co-processor van de UNO R4.
    De firmware gebruikt Serial1 (hardware UART) op D0 (RX) en D1 (TX).
2026-05-10 Fix ESP32 compile: vervang #pragma once door #ifndef guards
    Sommige ESP32-toolchains ondersteunen #pragma once niet betrouwbaar,
    wat leidt tot 'multiple definition of enum class Modus'. Alle headers
    krijgen nu klassieke #ifndef/#define/#endif guards.
    [eeprom.h, globals.h, knoppen.h, mqtt.h, protocol.h, types.h]
2026-05-10 Fix ESP32: EEPROM.h expliciet includen in eeprom.h en eeprom.cpp
    Sommige ESP32 toolchain-versies resolven <EEPROM.h> niet via de
    transitieve include-keten (globals.h). Directe include garandeert
    dat het EEPROM object altijd beschikbaar is.
    [eeprom.cpp, eeprom.h]
2026-05-10 Fix ESP32: gebruik Preferences (NVS) in plaats van EEPROM
    ESP32 Arduino core 3.x heeft geen EEPROM.h meer. Op ESP32 wordt
    nu Preferences gebruikt (ingebouwde NVS flash opslag). Op UNO R4
    blijft EEPROM ongewijzigd.
    - eeprom.cpp: conditionele compilatie #if ARDUINO_UNOR4_WIFI
    - types.h: EEPROM_BEGIN/COMMIT no-ops op ESP32 (niet meer nodig)
    - globals.h: <EEPROM.h> alleen includen op UNO R4
    - eeprom.h: expliciete <EEPROM.h> include verwijderd
    [eeprom.cpp, eeprom.h, globals.h, types.h]
2026-05-11 Fix ESP32 boot loop: GPIO6 crash en LCD hang
    - knoppen.h: BTN_DOWN 6→13 op ESP32 (GPIO6-11 zijn SPI-flash pins,
    pinMode(6) veroorzaakte directe TG1WDT_SYS_RESET crash)
    - types.h: USE_LCD standaard false op ESP32 (geen LCD aangesloten,
    lcd.init() blokkeerde I2C bus indefinitely)
    - chofu_wp_ff.ino: bare lcd.* setup-calls omhuld met #if USE_LCD
    (waren al buiten de if(USE_LCD) runtime-check)
    [chofu_wp_ff.ino, knoppen.h, types.h]
2026-05-11 docs: ervaringen en valkuilen opgeslagen
    Alle opgedane kennis uit de firmware-ontwikkeling gebundeld:
    - ESP32 GPIO6-11 flash-pins, EEPROM→Preferences, LCD hang,
    upload snelheid, #pragma once, Serial1 pins
    - UNO R4: SoftwareSerial conflict, WiFiS3.h
    - MQTT: 256-byte truncatie, HA unit validatie, retain-regels
    - EEPROM magic byte protocol + isnan-check
    - Gekalibreerde regelaar-parameters
    - Hardware-specificaties (ESP32 DevKit, Chofu Aurea 5, LCD)
    - Simulator gebruik en valkuilen
2026-05-11 wiring update
2026-05-11 Adam API: streaming XML parser voor intended_boiler_temperature
    - adam_api_test.ino: ESP32/UNO R4 sketch die via HTTP/1.1 het aanvoer
    setpoint van de Plugwise Adam ophaalt (~1s, leest alleen eerste 14%
    van de 215KB XML)
    - adam_discover.py: Python diagnostics script (zones, keteldata, types)
    - config.h.example: credentials template (config.h staat in .gitignore)
    - docs/ervaringen.md: Adam API sectie toegevoegd (HTTP/1.1 verplicht,
    chunked encoding, XML structuur, intended_boiler_temperature betekenis)
    Bevindingen:
    - Adam weigert HTTP/1.0 met 505; HTTP/1.1 is verplicht
    - Chunked encoding geen probleem voor streaming KMP-parser
    - intended_boiler_temperature op ~32KB (voor zone-elementen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
2026-05-11 README: links fixen, Adam API sectie en ontbrekende docs toevoegen
    - Docs-links: INSTALLATION/WIRING/MQTT_REFERENCE kregen docs/ prefix
    - Nieuwe sectie: Plugwise Adam integratie (adam_api_test/)
    - Docs-lijst: STOOKLIJN.md en ervaringen.md toegevoegd
    - Libraries: Arduino_LED_Matrix (UNO R4) en LCD als optioneel vermeld
2026-05-14 Simulatie-guard, protocol logging, water SP=0 fixes
    Simulatie:
    - sim_enabled vlag (default false): pas_sim_toe() doet niets als uit
    - sim_actief() geeft alleen true als sim_enabled=true
    - chofu/cmd/sim = 1/0 schakelt simulatie in/uit (reset alle sim-waarden bij uit)
    - wp_simulator.py: stuurt cmd/sim=1 bij connect, cmd/sim=0 bij afsluiten
    - Voorkomt dat retained chofu/sim/* berichten de echte regeling beinvloeden
    Protocol logging (schakelbaar via chofu/cmd/proto_log = 1):
    - chofu/proto/tx: TX telegram hex + stand/modus decoded
    - chofu/proto/rx: RX telegram hex + A/R/B/Hz/pomp/ontdooien decoded
    - chofu/proto/err: checksum fouten met berekend vs ontvangen
    - chofu/log/WARNING bij timeout (>5s g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
    [globals.cpp, globals.h, mqtt.cpp, mqtt.h, protocol.cpp, regelaar.cpp]
2026-05-16 Fix seriële baudrate: 9600 → 666 baud (Chofu protocol)
    [chofu_wp_ff.ino]
2026-05-16 Voeg JGC parser toe als schakelbare tweede parser
    - Klassieke 25-byte parser hernoemd naar stuur_stand_telegram_klassiek /
    lees_warmtepomp_data_klassiek
    - Nieuwe JGC parser: state machine (WachtStart/LeesHeader/LeesPayload/
    LeesEinde), variabele frame-lengtes (13/14/19/21 bytes), CRC-CCITT
    checksum, 4 TX-telegrammen roterend, stand in data2 met CRC
    - parser_jgc bool in globals (default false = klassiek)
    - Schakelen via MQTT: chofu/cmd/parser -> 'klassiek' of 'jgc'
    - HA discovery: select-entity op chofu/parser
    - Status gepubliceerd op chofu/parser
2026-05-16 Docs: baudrate 666 en dual parser gedocumenteerd
    - MQTT_REFERENCE: nieuwe state topics (proto_log, parser), protocol
    debug sectie met parser-selectie uitleg, teststrategie en baudrate
    vermelding; MQTT-boom uitgebreid met proto/* en cmd/parser
    - INSTALLATION: baudrate 666 baud vermeld bij bekabelingsinstructies
    - WIRING: baudrate 666 al gecorrigeerd in vorige commit
2026-05-16 LCD debug scherm bij proto_logging
    - Scherm 4 verschijnt automatisch als proto_logging=1:
    r0: 'DBG klas OK' / 'DBG jgc TOUT' (parser + RX status)
    r1: 'A:35.2 Err:3' (aanvoertemp + CRC-foutenteller)
    - proto_crc_fouten teller bijgehouden in globals, opgehoogd bij
    checksum/CRC fouten in klassieke en JGC parser
    - Teller reset bij parser-wissel via chofu/cmd/parser
    [display.cpp, globals.cpp, globals.h, mqtt.cpp, protocol.cpp]
2026-05-16 JGC timing: 99ms SendDelay, 2s timeout, 300ms min interval
    Identiek aan JGC origineel:
    - Wacht 99ms na einde ontvangen frame voor TX
    - Blokkeer TX tijdens ontvangst (jgc_is_ontvangend)
    - Noodstuur na 2000ms (was 5000ms)
    - Minimaal 300ms tussen twee sends
2026-05-17 Fix: verklein JGC buffers van 80 naar 25 bytes (max frame=21B)
    jgc_frames[4][80] -> [4][25]: bespaar 220B statisch RAM
    jgc_buf[80] -> [25]: bespaar 55B statisch RAM
    frame[80] in jgc_sla_frame_op -> [25]: minder stack gebruik
    [protocol.cpp]
2026-05-17 Fix: matrix standby-dot bij stand=0, verversing 4s→2s
    Bij stand=0 (WP uit) toont pagina 0 nu 4 pixels in het midden
    als standby-indicator ipv volledig donker scherm.
    Matrix verversinterval verlaagd van 4000ms naar 2000ms zodat
    alle 3 pagina's sneller zichtbaar zijn (totale cyclus: 6s).
    [display.cpp]
2026-06-11 Add verbose MQTT init debug output to serial console
    - Log broker IP and port before connecting
    - Log MQTT username
    - Log LWT setup, connect attempt, subscriptions and status publish
    - Print connectError() code on failure (both init and reconnect)
    - Reconnect function also logs broker:port and error code
    [chofu_wp_ff.ino]
2026-06-11 Fix: add forward declaration for stuur_stand_telegram_jgc()
    Called at line 267 but defined at line 280 — add forward declaration
    at the top of protocol.cpp to resolve the compile error.
    [protocol.cpp]
2026-06-11 Fix LED matrix: initialiseer na WiFi.begin() i.p.v. ervoor
    Op de UNO R4 WiFi reset de WiFi-library hardware-timers die door
    de LED-matrix ISR (FspTimer) worden gebruikt. Door matrix.begin()
    vóór WiFi.begin() te plaatsen vervalt de timer en licht de matrix
    niet op.
    Oplossing: matrix.begin() verplaatst naar het einde van setup(),
    na volledige WiFi/MQTT-initialisatie. Resultaat van begin() wordt
    nu ook gelogd op de seriële console.
    [chofu_wp_ff.ino]
2026-06-11 LED matrix: voeg hardware-test toe na begin()
    Na begin() toont de matrix 3s een hart (LEDMATRIX_HEART_BIG).
    Dit onderscheidt twee mogelijke oorzaken:
    - Hart zichtbaar → hardware/ISR OK, probleem in update_matrix()
    - Donker blijft → dieper hardware-/timerprobleem
2026-06-11 Fix LED matrix: vervang renderBitmap() door directe loadFrame() aanroep
    renderBitmap is een macro die loadPixels() → loadPixelsToBuffer() aanroept.
    loadPixelsToBuffer() heeft een carry-over probleem bij 32-pixel groepsgrenzen
    waardoor het frame niet correct wordt doorgegeven aan loadFrame().
    Oplossing: bereken zelf de uint32_t[3] representatie en roep loadFrame()
    direct aan. Formaat: LED-index i → bit (31 - i%32) van buf[i/32],
    waarbij LED-index = row*12 + col. Dit is hetzelfde formaat als de
    gallery-patronen (LEDMATRIX_HEART_BIG etc.) die wél werken.
    [display.cpp]
2026-06-11 DEBUG: loop-test LED matrix ISR op t=10s (tijdelijk)
2026-06-11 DEBUG: print fb-waarden in update_matrix() (tijdelijk)
2026-06-11 Fix LED matrix: verplaats loadFrame() naar .ino (zelfde TU als ISR)
    De 'static framebuffer' in Arduino_LED_Matrix.h heeft per translation
    unit een eigen kopie. De ISR (gecompileerd in de .ino) leest de .ino-
    kopie; loadFrame() vanuit display.cpp schreef naar de display.cpp-kopie
    — twee verschillende geheugenlocaties waardoor niets zichtbaar was.
    Oplossing: update_matrix() berekent het uint32_t[3]-frame en slaat het
    op in de globals matrix_fb[]/matrix_fb_klaar. De .ino roept
    matrix.loadFrame(matrix_fb) aan vanuit dezelfde TU als de ISR, zodat
    altijd de juiste framebuffer wordt bijgewerkt.
    [chofu_wp_ff.ino, display.cpp, globals.cpp, globals.h]
2026-06-12 wiring was switched
2026-06-12 Fix JGC parser: geen eindnul-terminator op UNO R4 (AVR break-artefact)
    - Payload = msg_len-4 bytes, frame compleet na payload (geen LeesEinde-state):
    de 'eindnul' uit jgc.ino is een AVR-artefact (break -> 0x00) dat de
    Renesas-UART wegfiltert. RX-verlies van ~100% naar ~0%.
    - jgc_is_ontvangend blijft waar mid-frame; TX wacht >=99ms na laatste byte;
    mid-frame timeout 600ms (abort-teller).
    - Koelvlag 0x02 in jgc_tx2 (bevestigd door JGC-auteur).
    - Spike-guard deadlock gefixt: prev ook bij afwijzing bijwerken.
    - Hex proto-logging uit het RX-pad (uitgesteld, max 1/s) + 30s samenvatting.
    - sniffer/: standalone JGC poll-sniffer voor busdiagnose zonder WiFi.
    [protocol.cpp, sniffer.ino]
2026-06-14 power failure
2026-06-15 feat: configureerbare MQTT-prefix + HA-device + unieke client-ID (test naast productie); sim --prefix
2026-06-17 feat(ha): configuration_url (link naar lokale webpagina) in MQTT-discovery device
2026-06-17 fix(mqtt): proto_log/seriallog status direct + retained terugmelden (HA-schakelaar klapt niet meer terug)
    [mqtt.cpp]
2026-06-20 fix(lcd): her-init interval naar 5 min
    [display.cpp]
2026-06-21 fix(koeling): doodband ~1C — geen onnodige opschaling bij kleine mismatch
    [regelaar.cpp]
2026-06-21 fix(mqtt): robuuste reconnect (wifiClient.stop + backoff) op main tegen -2
    [chofu_wp_ff.ino]
2026-06-21 feat(web): uitleg (hint) onder elke setting uit de documentatie
2026-06-22 fix: defrost-vlag negeren in koeling (byte heeft daar andere betekenis)
    [protocol.cpp]
2026-06-22 fix(web): step=any tegen HTML5 step-validatie die formulier-submit blokkeerde
    [web.cpp]
2026-07-11 Adam: foutdiagnose — reden op chofu/adam/fout + WARNING per mislukte poll (incl. HTTP-statuscode)
2026-07-11 Web-UI: Adam-tab met status (SP, fout, zones, actieve zone) en bediening (bron, koel-SP)
    - Alias 'water_kamer' voor cmd/adam_bron: het webformulier kan geen '+'
    door de query string sturen (URL-encoding).
    - adam_ip_str() accessor voor weergave geconfigureerd IP.
2026-07-11 Fix frame 91-3 mapping: byte 9 = stand-echo, byte 10 = vermogen/25.6
    chofu/pomp ('pompsnelheid') en chofu/comp_hz waren verkeerd gelabeld
    (aanname uit klassiek protocol). chofu/vermogen is nu het gemeten
    compressorvermogen (25.6 x byte 10) i.p.v. een schatting uit een
    niet-bestaande Hz-waarde; chofu/stand_echo vervangt comp_hz; chofu/pomp
    vervalt. LCD en web-UI tonen W i.p.v. Hz. Docs bijgewerkt.
2026-07-12 Adam: fix 20s-timeout — leesbudget 512->2048 bytes/doorgang + vroege exit
    De volledige 215KB XML uitlezen op 512 bytes per loop-doorgang duurde
    langer dan de harde 20s-limiet. Nu: 2048 bytes budget (~1s voor de hele
    stream) en vroegtijdig afronden zodra SP + zones binnen zijn en er 16KB
    lang geen nieuwe <location meer verschijnt (bespaart de resterende
    ~170KB van de XML).
2026-07-12 Adam: status 'init' tot eerste geslaagde poll + directe poll na bronwissel
    Status toonde 'fout' + oude foutmelding direct bij inschakelen, nog voor
    de eerste poll (die tot 30s kon wachten). Nu: init-status, en een
    bronwissel reset backoff/foutmelding en pollt meteen.
2026-07-12 Adam: stall-detectie — >3s geen bytes bij open verbinding -> afronden met wat er is
2026-07-12 Adam: twee gerichte requests i.p.v. domain_objects (WiFiS3 stall >76KB)
    De download van domain_objects (200KB+) stokt op de WiFiS3 rond 76KB;
    intended_boiler_temperature staat daar (82KB) net voorbij. Nu per poll:
    1) /core/appliances;class=heater_central -> SP (paar KB, stopt zodra
    de waarde binnen is)
    2) /core/locations -> zones (klein document)
    Stall of verbindingseinde in fase 1 rondt af met wat er is; fase 0 gaat
    altijd door naar de zones. Host-tests aangepast en groen.
2026-07-12 Docs: WiFiS3 76KB download-stall vastgelegd in ervaringen
2026-07-15 Docs: SoftwareSerial-optie heroverwogen (officiele R4-core: GPT+DMA) — te testen, RX-only eerst
2026-07-15 OT-link fase 1: RX-only module (EXPERIMENTEEL, branch feature/ot-link)
    - ot.h/ot.cpp: 12-byte frames, som-checksum, sliding-window resync;
    byte 0 -> ot_sp (Anna aanvoersetpoint). Geen TX — fase 2, met harde
    gate ot_mag_zenden() (>=3 geldige frames) als IC1-bescherming.
    - UNO R4: officiele SoftwareSerial (GPT+DMA) uit renesas-core >=1.6;
    ESP32: hardware UART1. Activeren via OT_RX_PIN in config.h.
    - MQTT: chofu/ot/status|frames|sp + laatste frame als hex op
    chofu/ot/raw (met proto_log aan, voor reverse engineering bytes 1-10).
    - Afbreekcriteria voor de test: JGC (30s)-statistiek gelijk, MQTT
    stabiel, geen reboots (zie OPENTHERM_LINK_PLAN.md).
2026-07-15 Docs: pinmapping IC-voetje uit Tweakers-thread (pin 2/3 = OT-link, pin 16 = ketelrelais)
2026-07-31 Docs: OT-plan geactualiseerd met chip-dump-bevindingen (data/atlantic)
    - Naamgeving gecorrigeerd: T1.1/IC2 = OT-brug (blijft), M1.1/IC1 = vervangen chip
    - Fase 2-framespec uit binary: kop 0xF0, temps op 7/8/9, statuscode 0 op
    byte 10 dooft de storingsled, som op 11
    - T1.1 is een transparante OT-brug met 5 onderscheppingspunten (ID25/28 =
    WP-temperaturen naar Anna); ketel via OT, niet via relais (pin-16-info
    uit thread twijfelachtig)
2026-07-31 Docs: chip-dump-inzichten in ervaringen + OT-plan consistentie (T1.1-naamgeving, pin 16)
2026-07-31 Standbereik begrensd op 10 (fabrieksbereik uit chip-dump)
    - VERMOGEN-tabel: standen 11/12 (1750/1800W, extrapolaties) geschrapt
    - Handmatig bereik 0-10 in MQTT-cmd, HA-discovery, web-UI en knoppen
    - LED-matrix standbar en stand_echo-commentaar aangepast
    - Bijvangst: out-of-bounds leesfout in ff_stand_voor_vermogen (liep tot
    index 12 in de nu 11-element tabel) gefixt
    - README + MQTT_REFERENCE bijgewerkt
2026-07-31 Docs: OT-link pinrichting bevestigd uit chip-dump (pin 2 = RX, pin 3 = TX)
2026-07-31 OT: interne pull-up op RX-pin — geen ruis-bytes bij niet-aangesloten draad
2026-07-31 Docs: OT-link bedrading (fase 1 RX-only) in WIRING.md + README
2026-10-11 FF_WATER: deadband ±2°C — stand vasthouden binnen band voor rustiger draaien
2026-11-01 Protocol: extra pompwaarden uit 0x91-frames (Hz, persgas, stroom, vrijgave, circulatiepomp)
    - 91-3 byte 9 is stroom (d3 = /5), geen stand-echo: chofu/stand_echo → chofu/stroom
    - Nieuw: comp_hz, t_persgas, comp_vrijgave, circ_pomp (+ HA-discovery) en chofu/diag
    (verdamper, zuiggas, d4, ventilator, EEV, statusbytes); pagina-0-check op 91-2
    - Alert bij wijziging van alarmbytes 91-1 b5-8
    - Oude HA-entiteiten pomp/stand_echo opgeruimd; bron: docs/extra-comm-info.txt
2026-11-01 FF_WATER: minimaal stand 1 zolang Adam warmtevraag geeft, zachte start op stand 1
    - Te warm: niet naar 0 maar hooguit naar stand 1 (voorkomt aan/uit-pendelen bij
    zacht weer; Adam beëindigt de warmtevraag zelf via SP = 0)
    - Vanuit 0 altijd starten op stand 1, zonder HYST_SLOW-wachttijd
    - TUNING.md: deadband-tekst bijgewerkt (stand 0 alleen nog bij SP = 0)
    Getest op de WP.
2026-11-10 ESPHome: aurea-wp.yaml voor de Device Builder (Aapjedotinfo @ 651aae3)
    - avr_versie "1", componenten en AVR-pakket uit hun git-repo
    - Stooklijn-modus stookt alleen bij warmtevraag van de thermostaat (ID1 >= 20)
    - Haakjes rond ${thermo_ok}: bij v1 is dat `A || B`, waardoor `!${thermo_ok}`
    als `!A || B` werd gelezen en de koppeling vrijwel altijd "geen thermostaat"
    gaf (WP uit ondanks warmtevraag). Getest op de WP.
