jaapschellekens/aurea5-chofu-ctrl/(notices)

Notices in the files:
README.md:
License: MIT
